Jay-esp/modular_tester/dmx_tester/modular_tester_dmx_v1_1.png

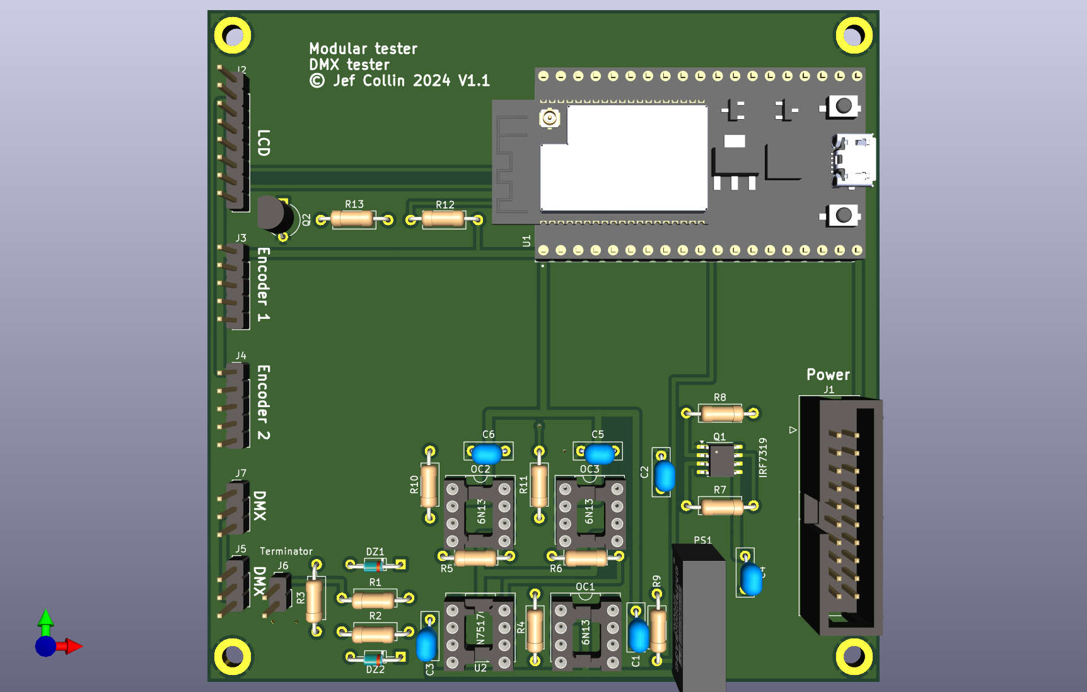
dmx_tester/modular_tester_dmx_v1_1.png
