Jay-esp/modular_tester/battery_tester/modular_tester_battery_tester_1_1.png

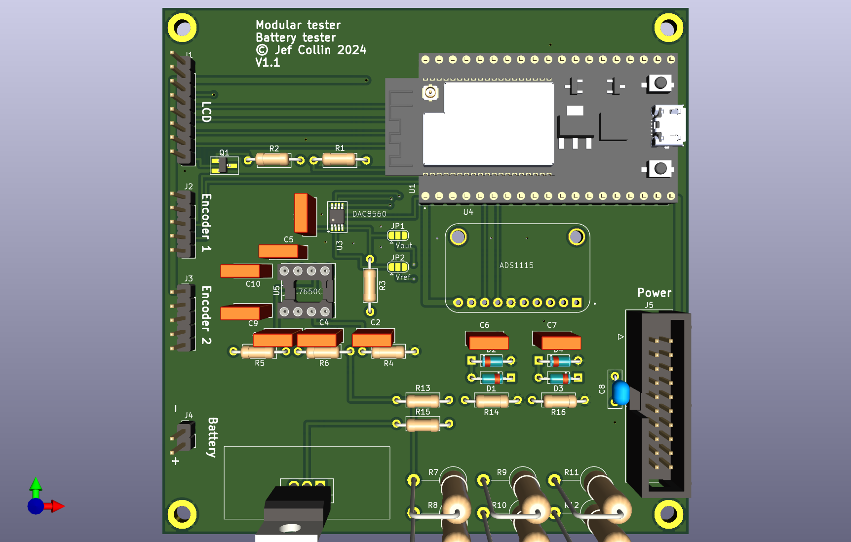
battery_tester/modular_tester_battery_tester_1_1.png
