Jay-esp/modular_tester/capacitor_foil_side_tester/modular_tester_capacitor_foil_side_1_2.png

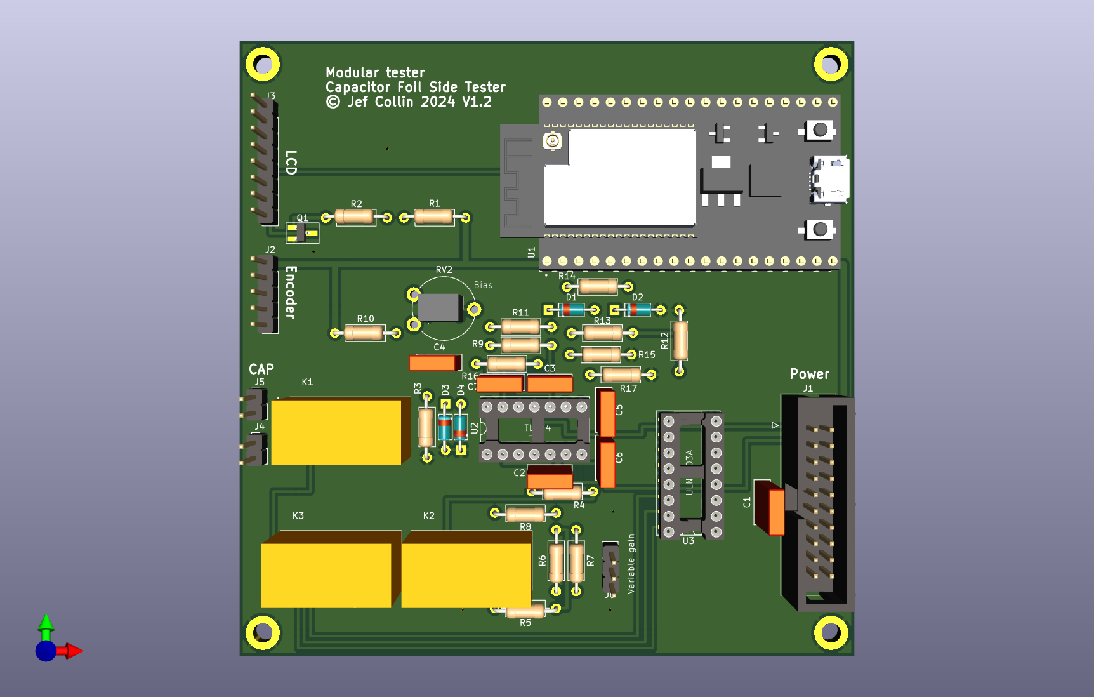
capacitor_foil_side_tester/modular_tester_capacitor_foil_side_1_2.png
