Jay-esp/modular_tester/esr_meter/modular_tester_esr_v2_1.png

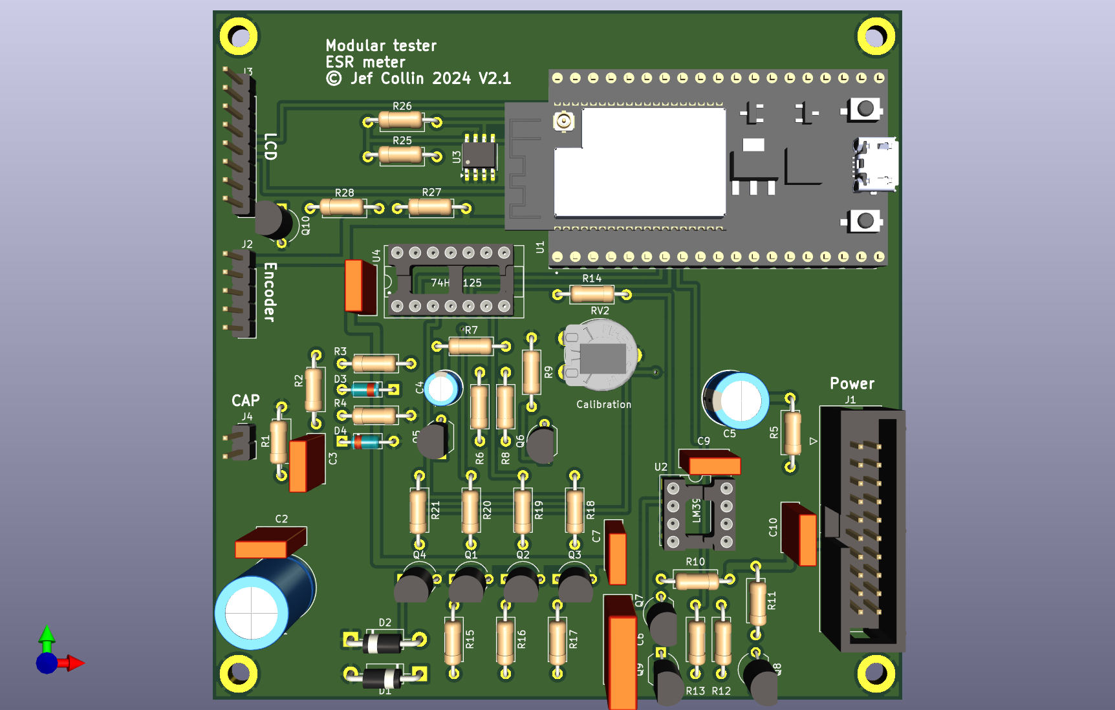
esr_meter/modular_tester_esr_v2_1.png
