Jay-esp/modular_tester/noise_generator/modular_tester_noise_1_1.png

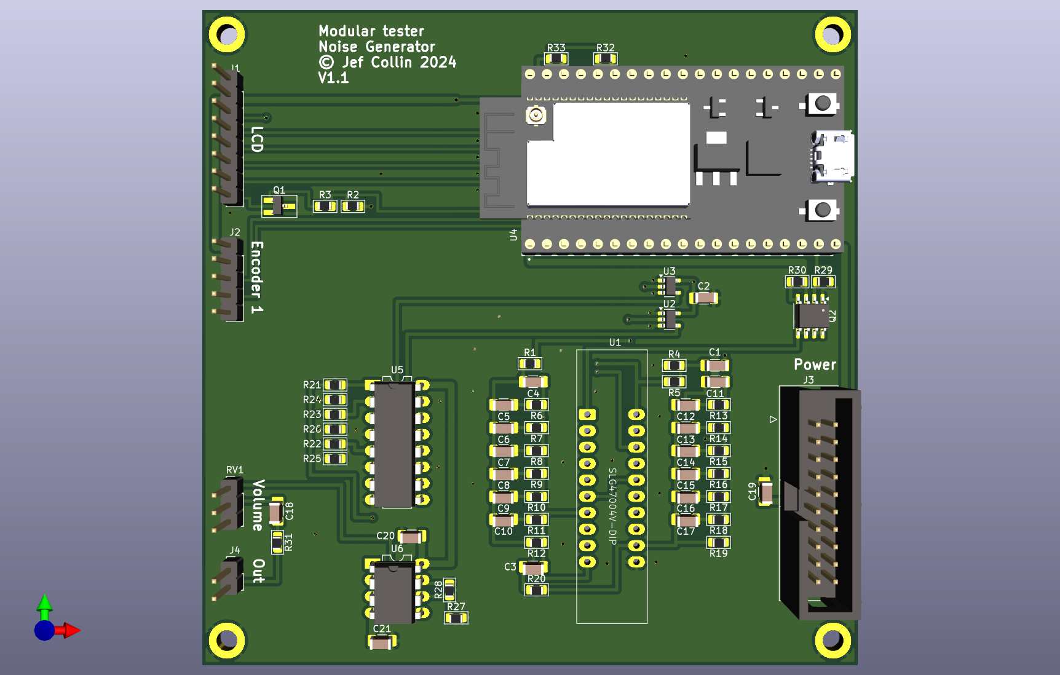
noise_generator/modular_tester_noise_1_1.png
