Jay-esp/modular_tester/rack_power_board/modular_tester_rack_power2.png

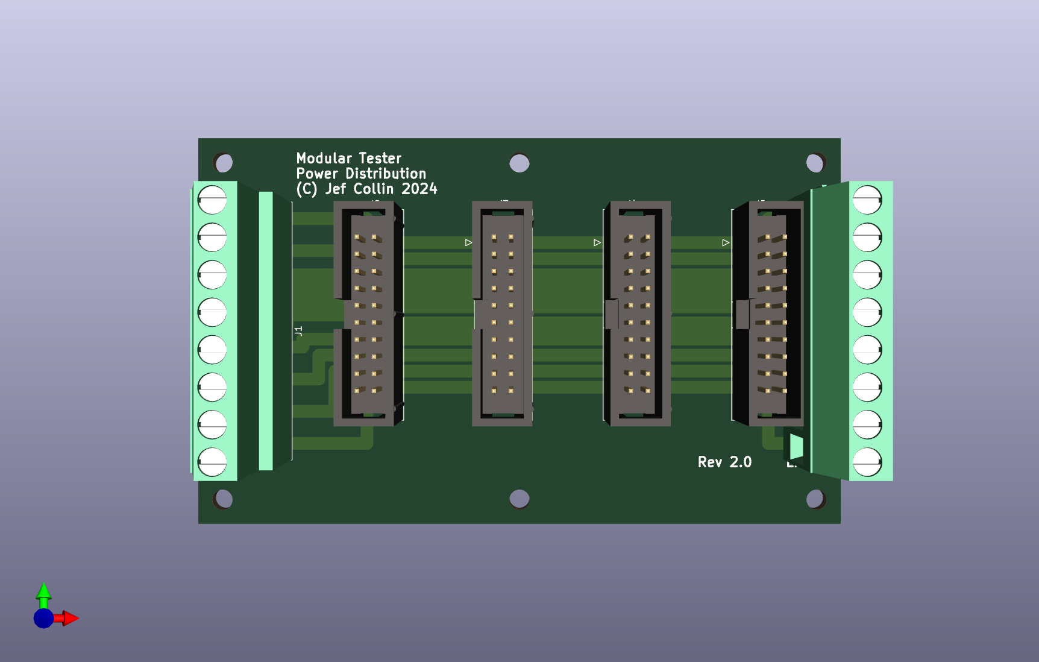
rack_power_board/modular_tester_rack_power2.png
