Jay-esp/modular_tester/rf_probe_up/modular_tester_rf_probe_mcl_1_0.png

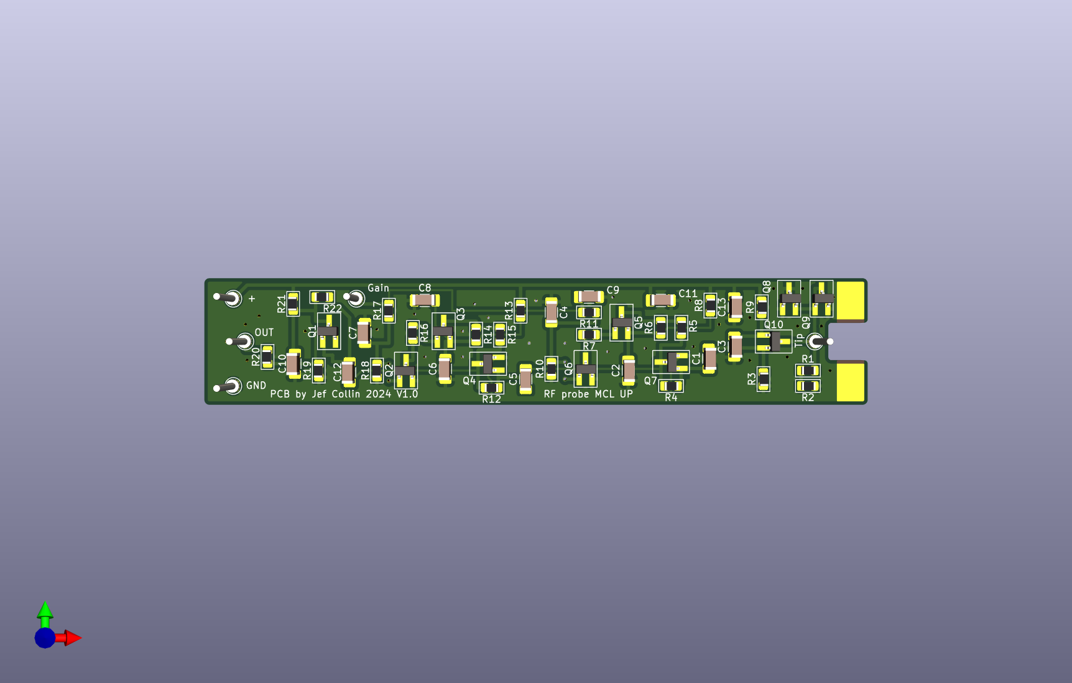
rf_probe_up/modular_tester_rf_probe_mcl_1_0.png
