Jay-esp/modular_tester/ring_tester/modular_tester_ring_tester_1_0.png

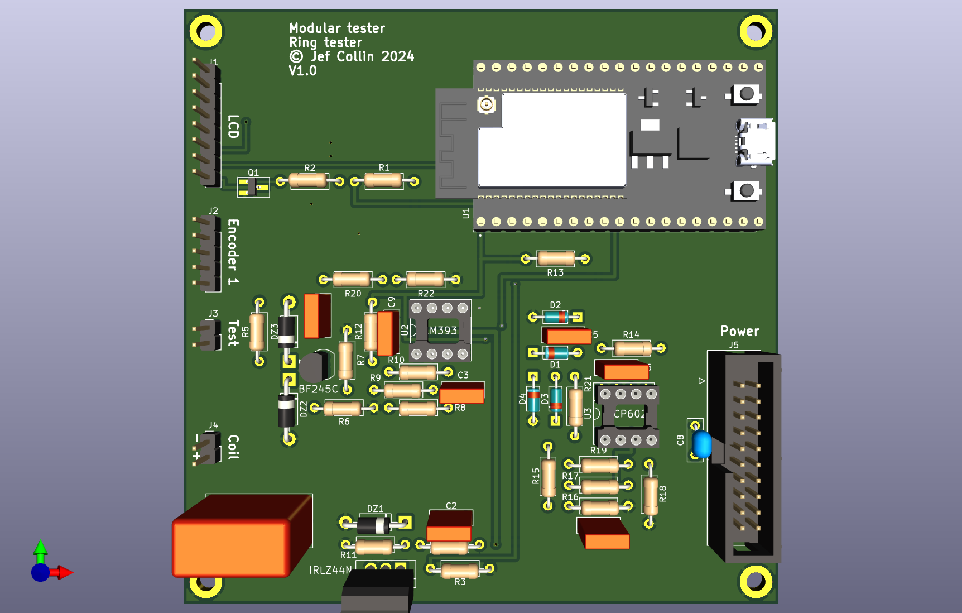
ring_tester/modular_tester_ring_tester_1_0.png
