Jay-esp/modular_tester/short_seeker/modular_tester_short_seeker_1_1.png

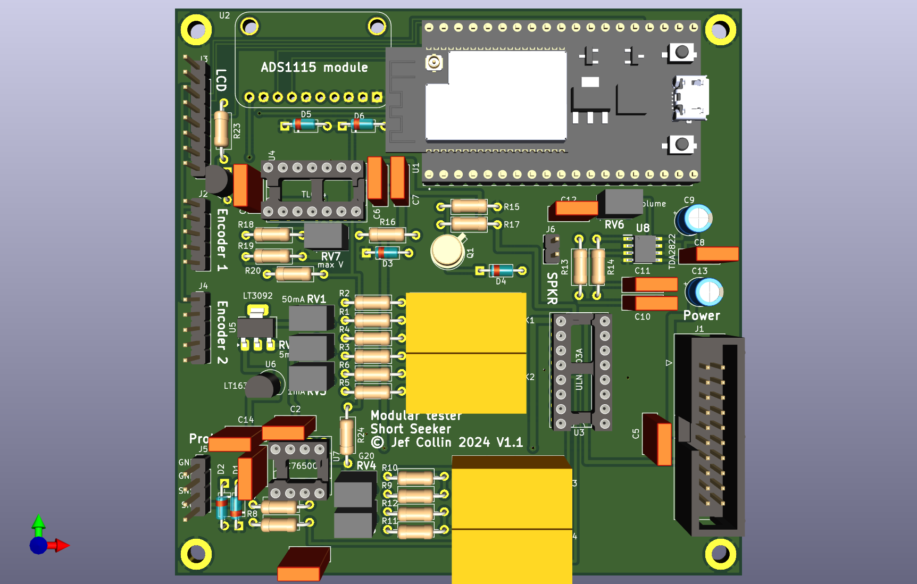
short_seeker/modular_tester_short_seeker_1_1.png
