Jay-esp/modular_tester/signal_tracer/modular_tester_signal_tracer_1_1.png

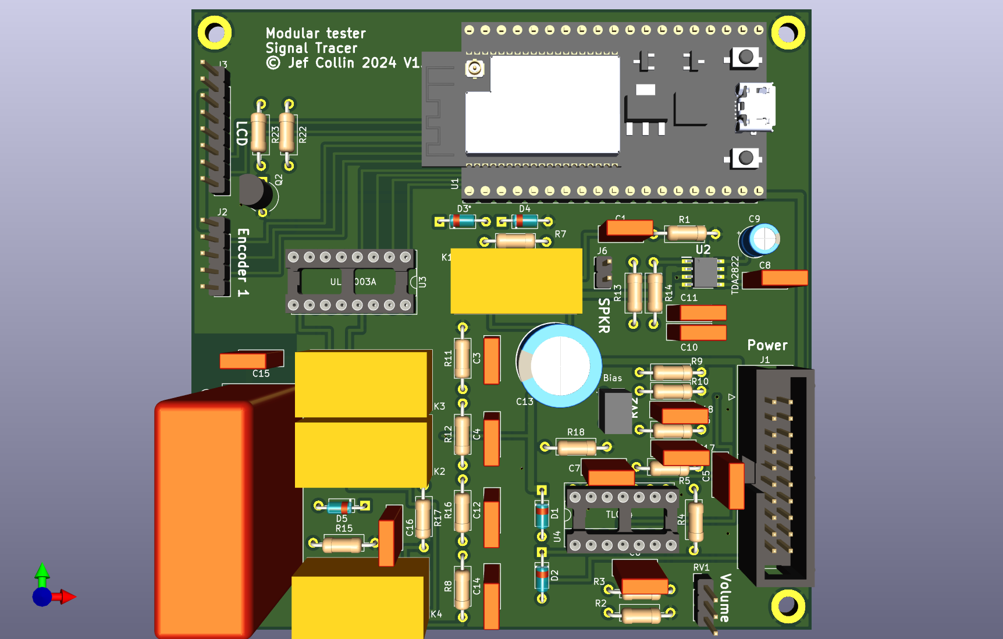
signal_tracer/modular_tester_signal_tracer_1_1.png
