Jay-esp/modular_tester/vi_tracker/modular_tester_vi_tracker_input_1_1.png

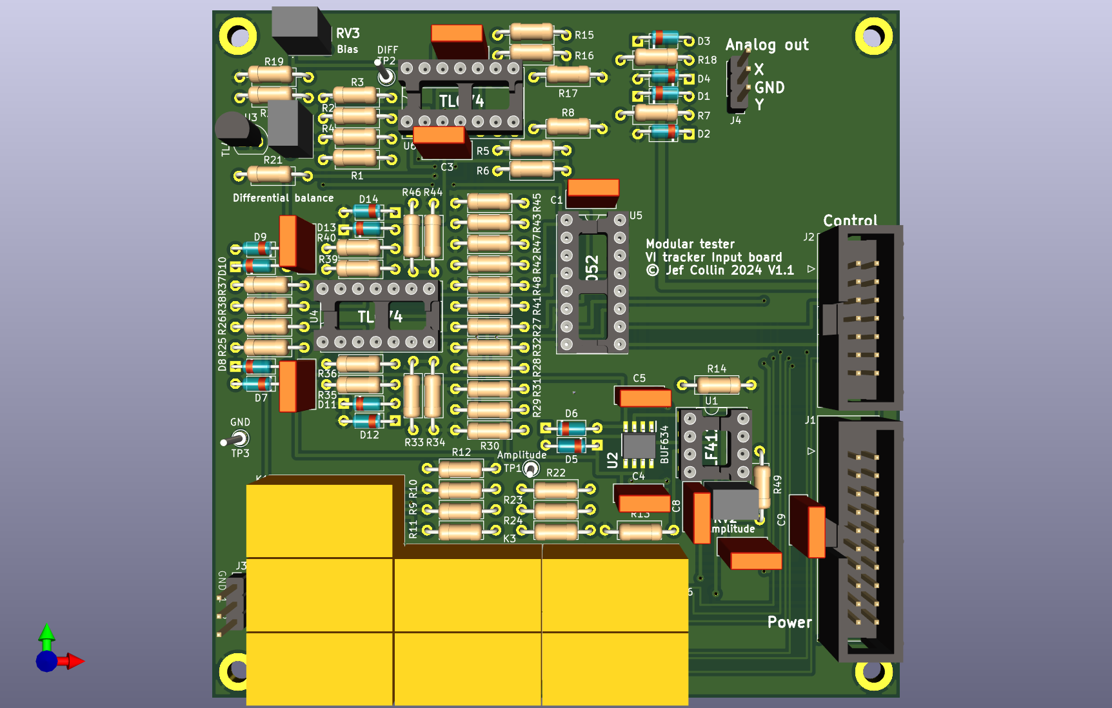
vi_tracker/modular_tester_vi_tracker_input_1_1.png
