Jay-esp/modular_tester/noise_generator/modular_tester_noise_1_1.pdf

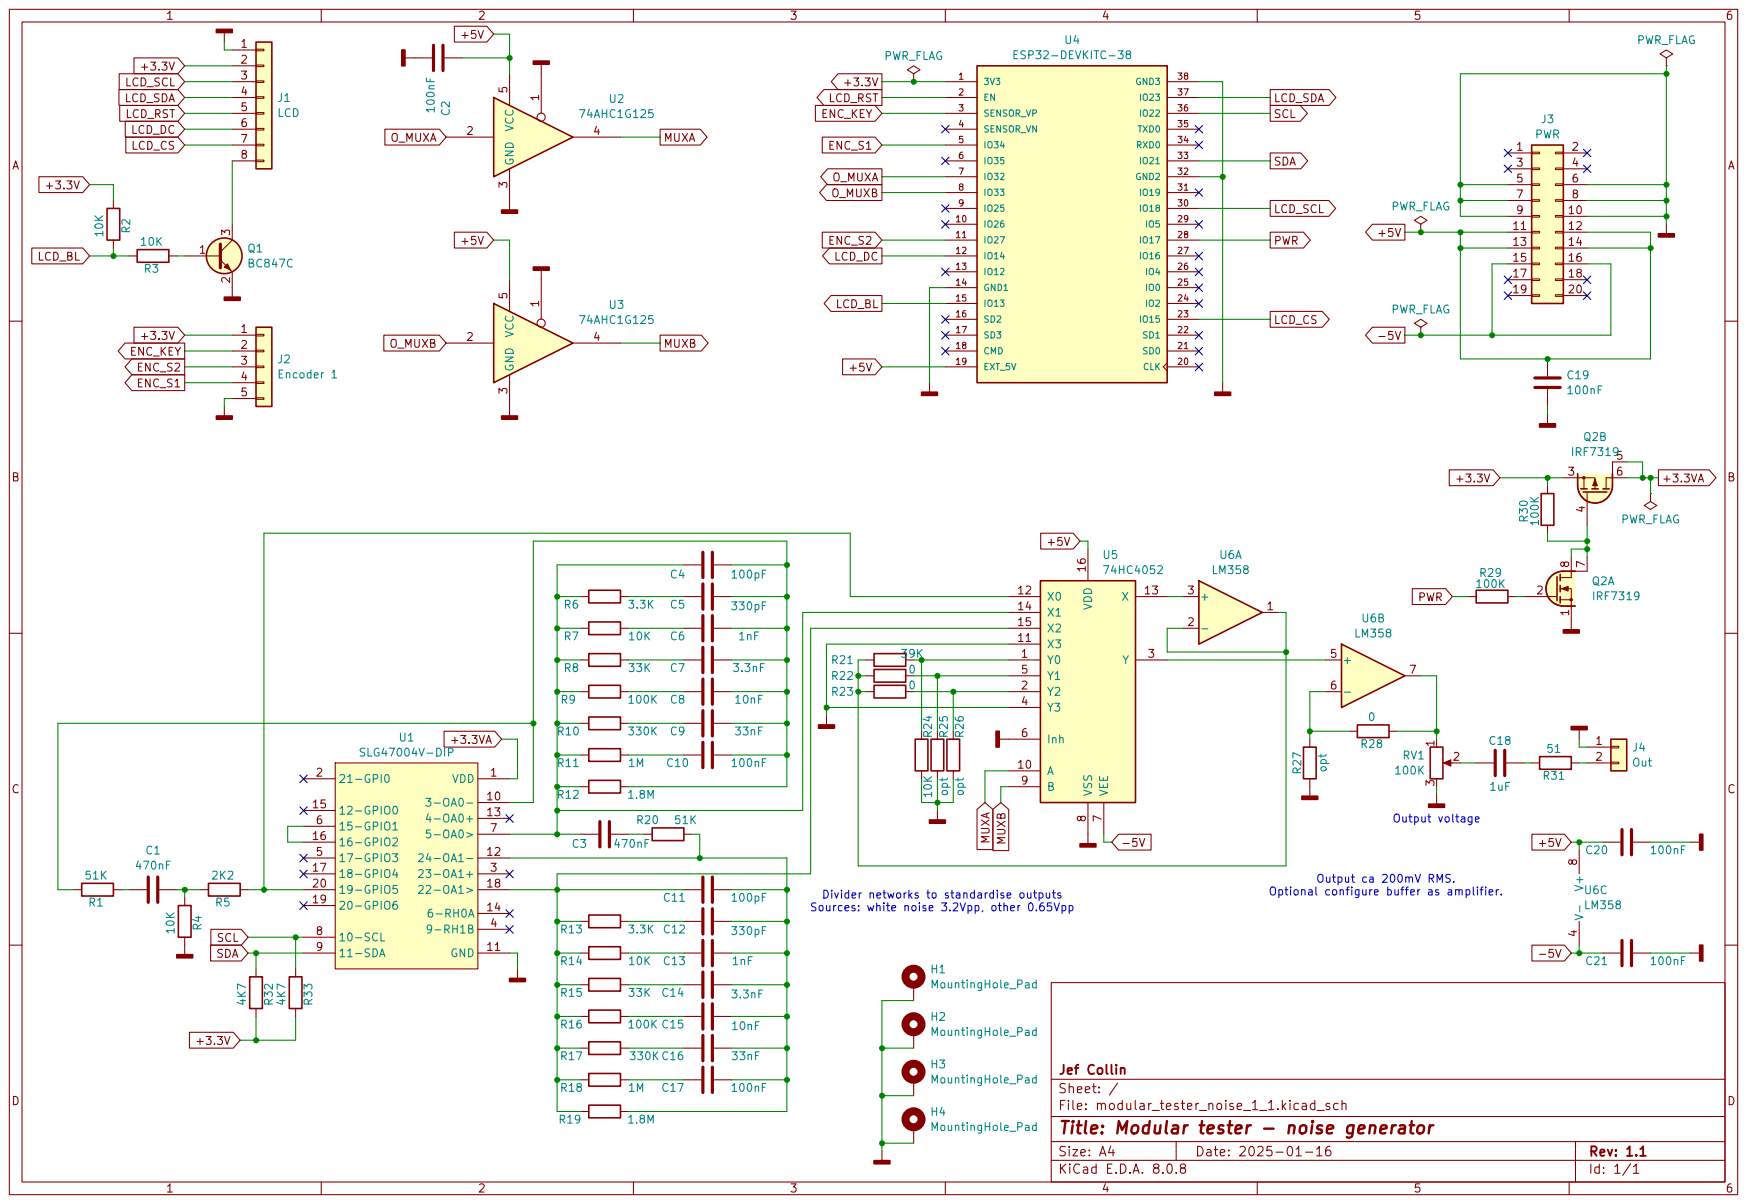
[picture p84: page 1]
