Jay-esp/modular_tester/fm_transmitter/modular_tester_fm_tx_1_1.pdf

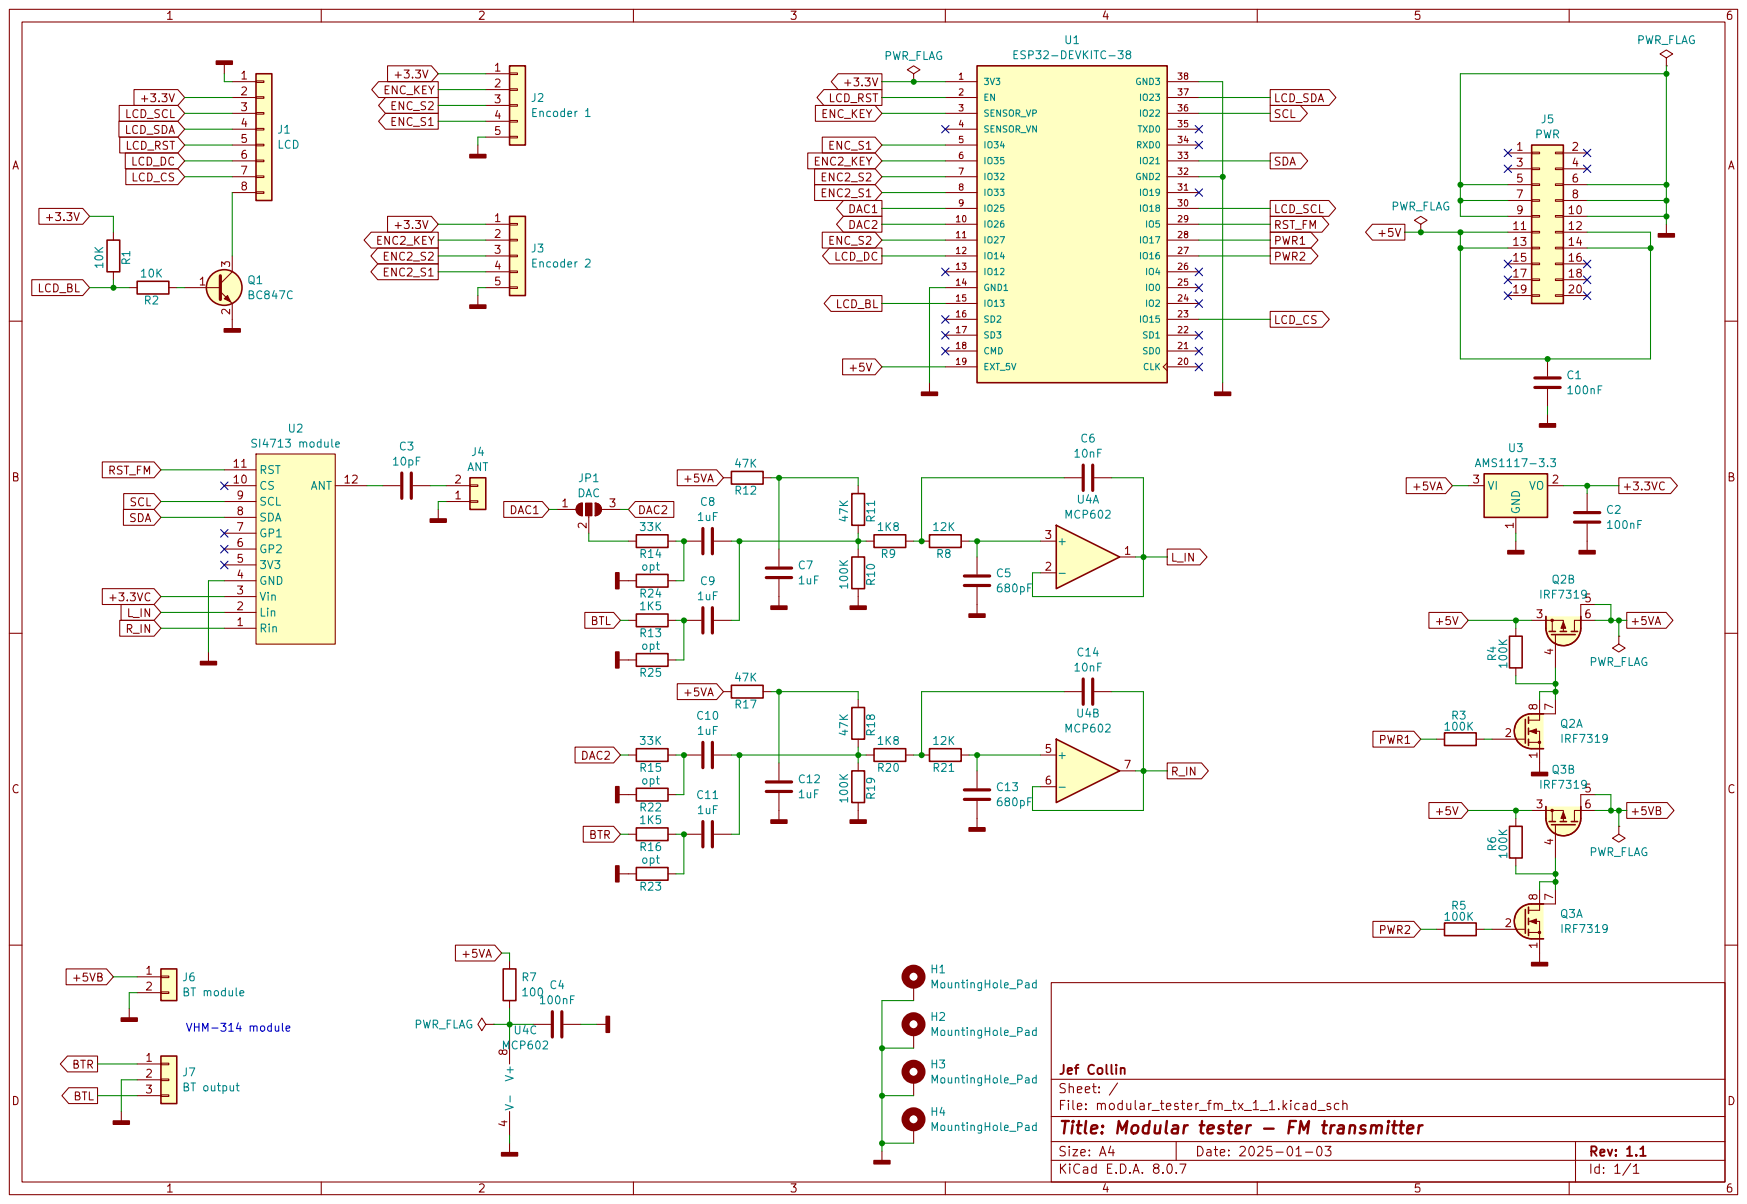
[picture p85: page 1]
