Jay-esp/modular_tester/battery_tester/modular_tester_battery_tester_1_1.pdf

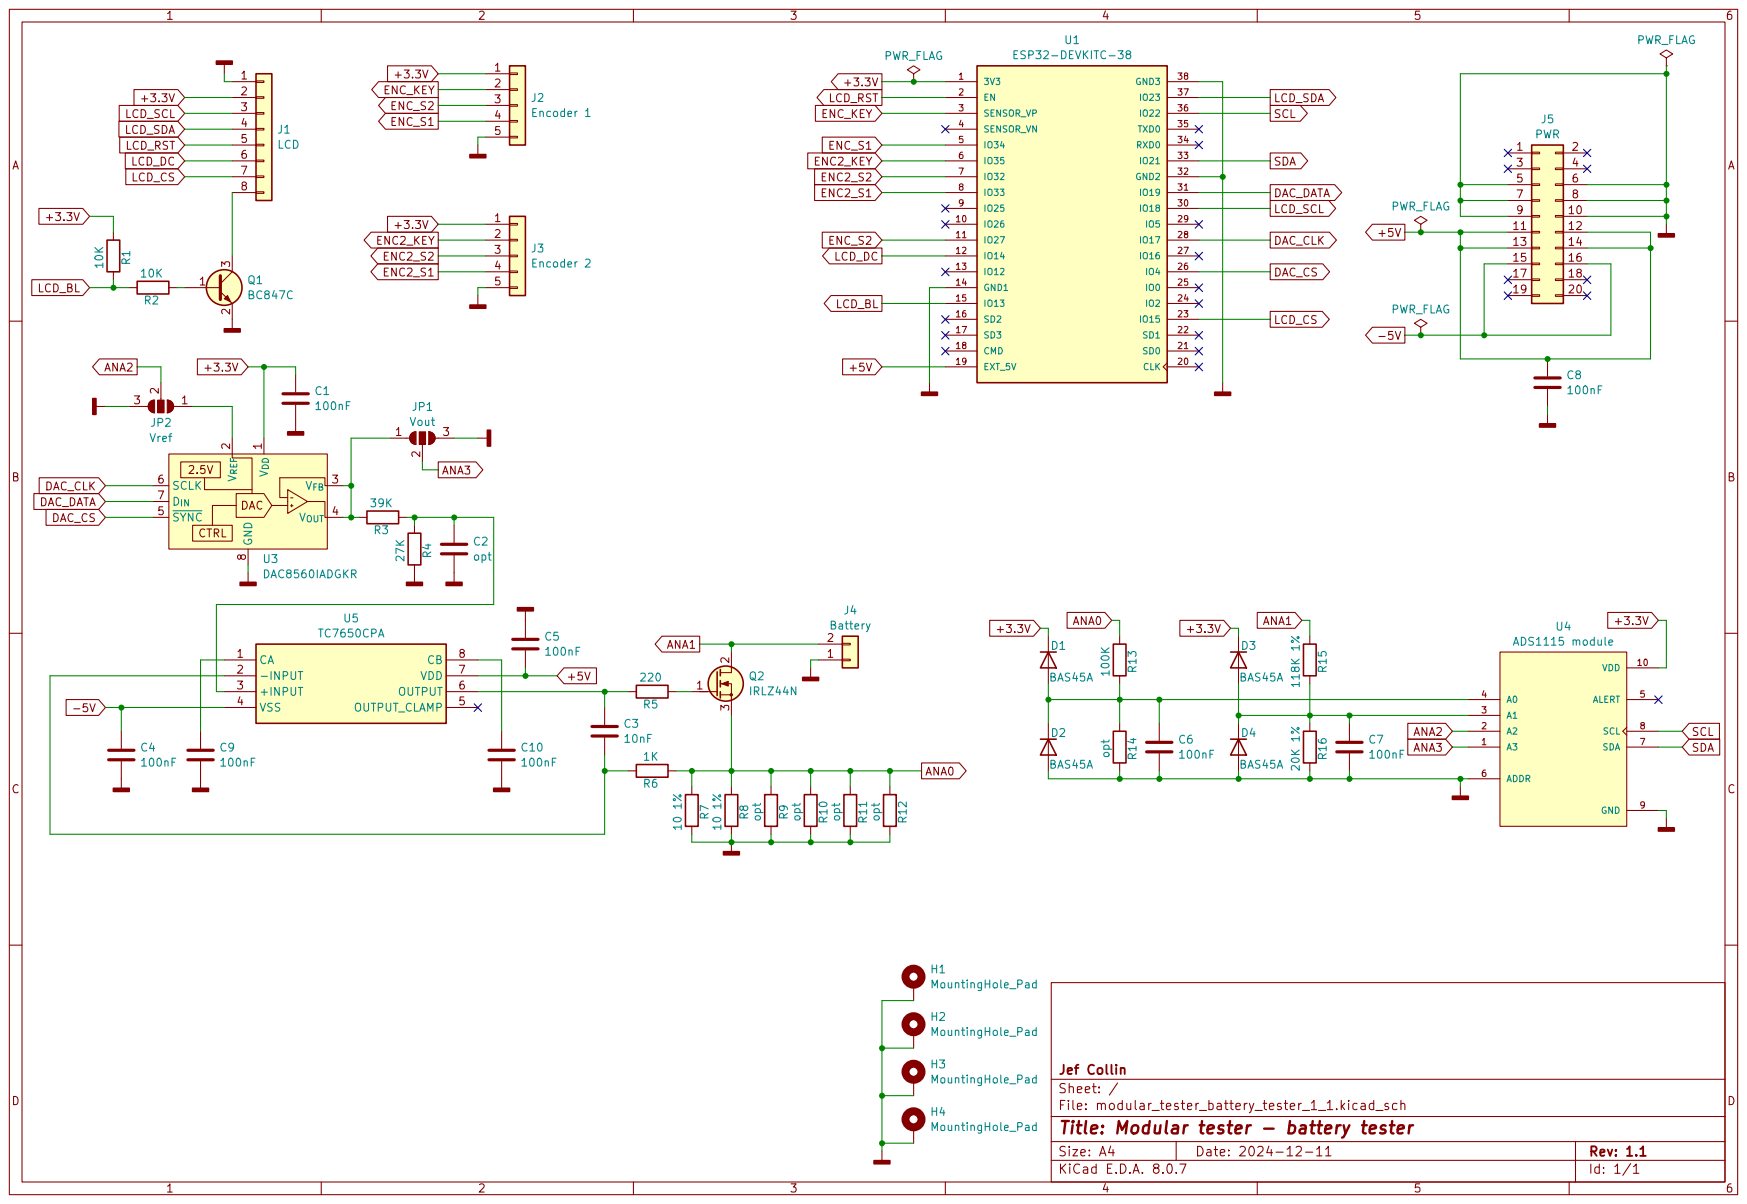
[picture p86: page 1]
