Jay-esp/modular_tester/LED_tester/modular_tester_led_tester_1_1.pdf

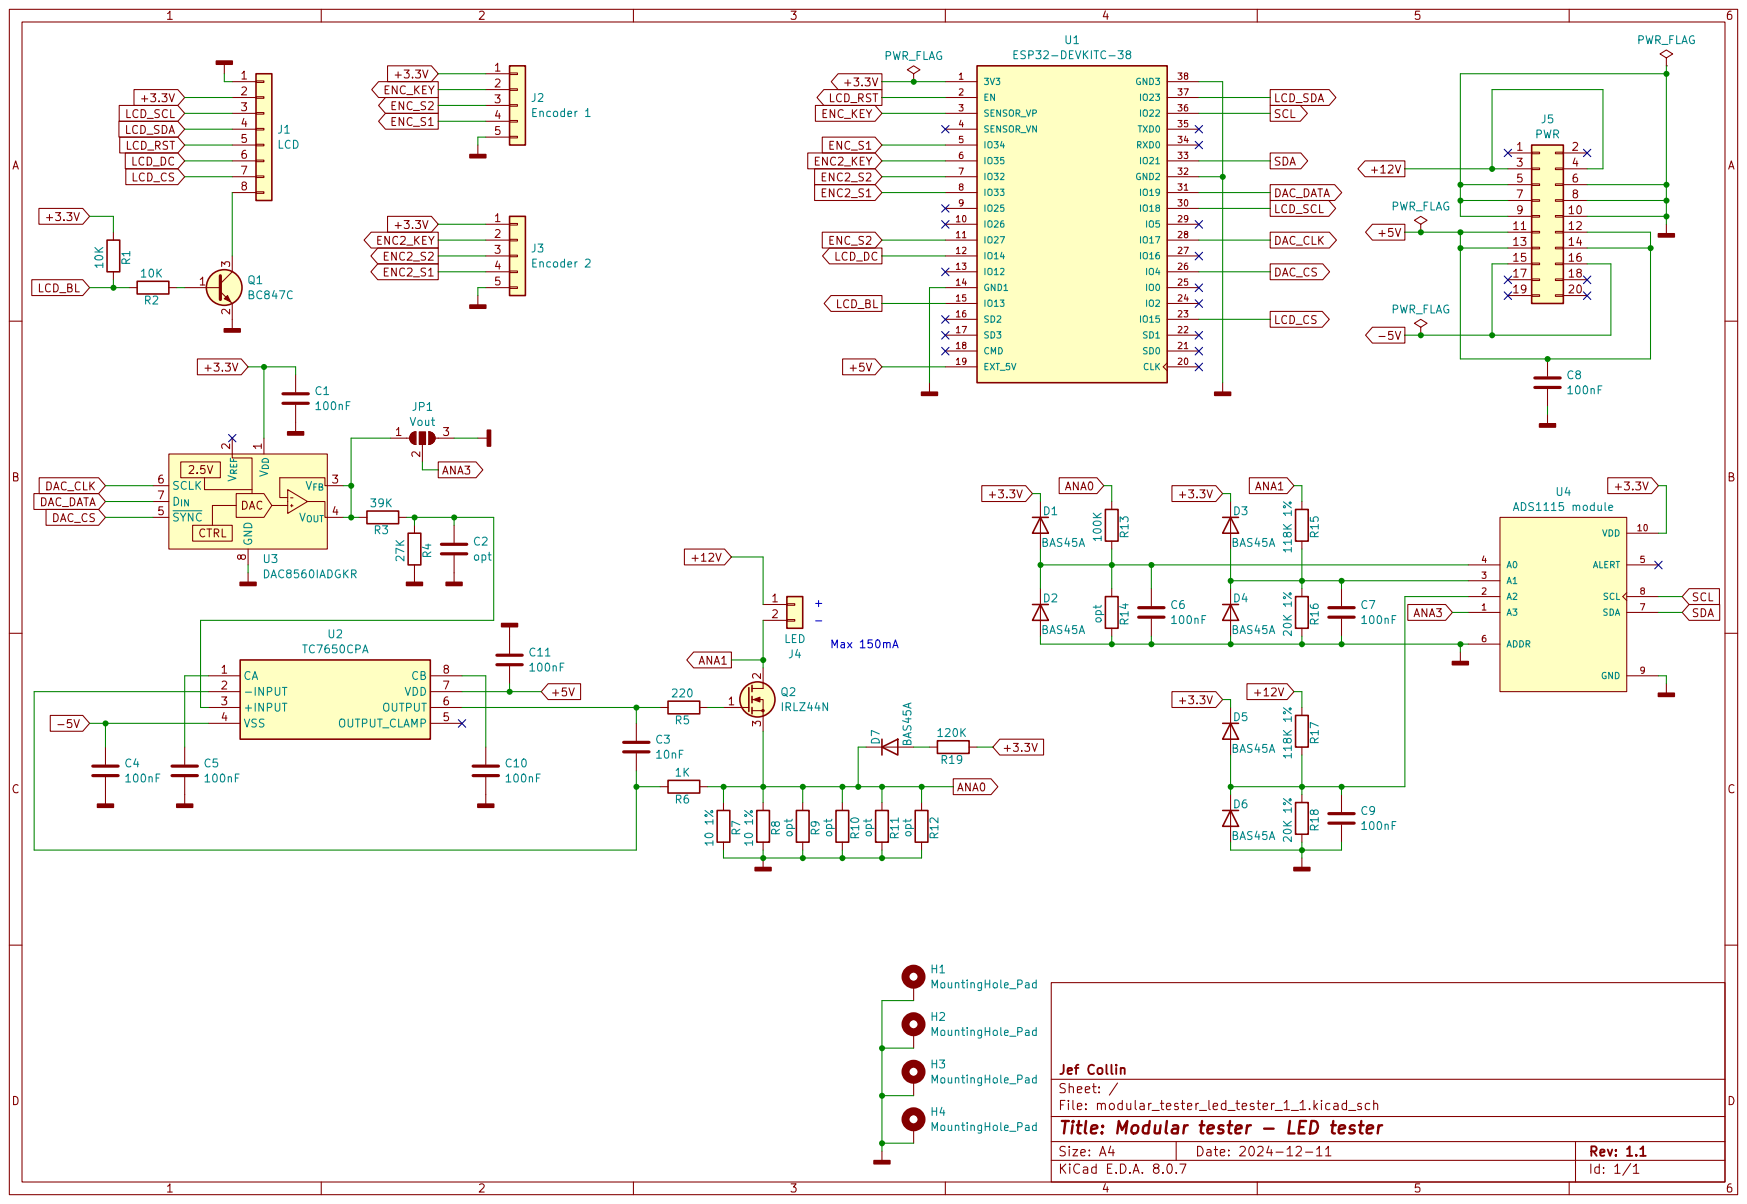
[picture p87: page 1]
