Jay-esp/modular_tester/ring_tester/modular_tester_ring_tester_1_0.pdf

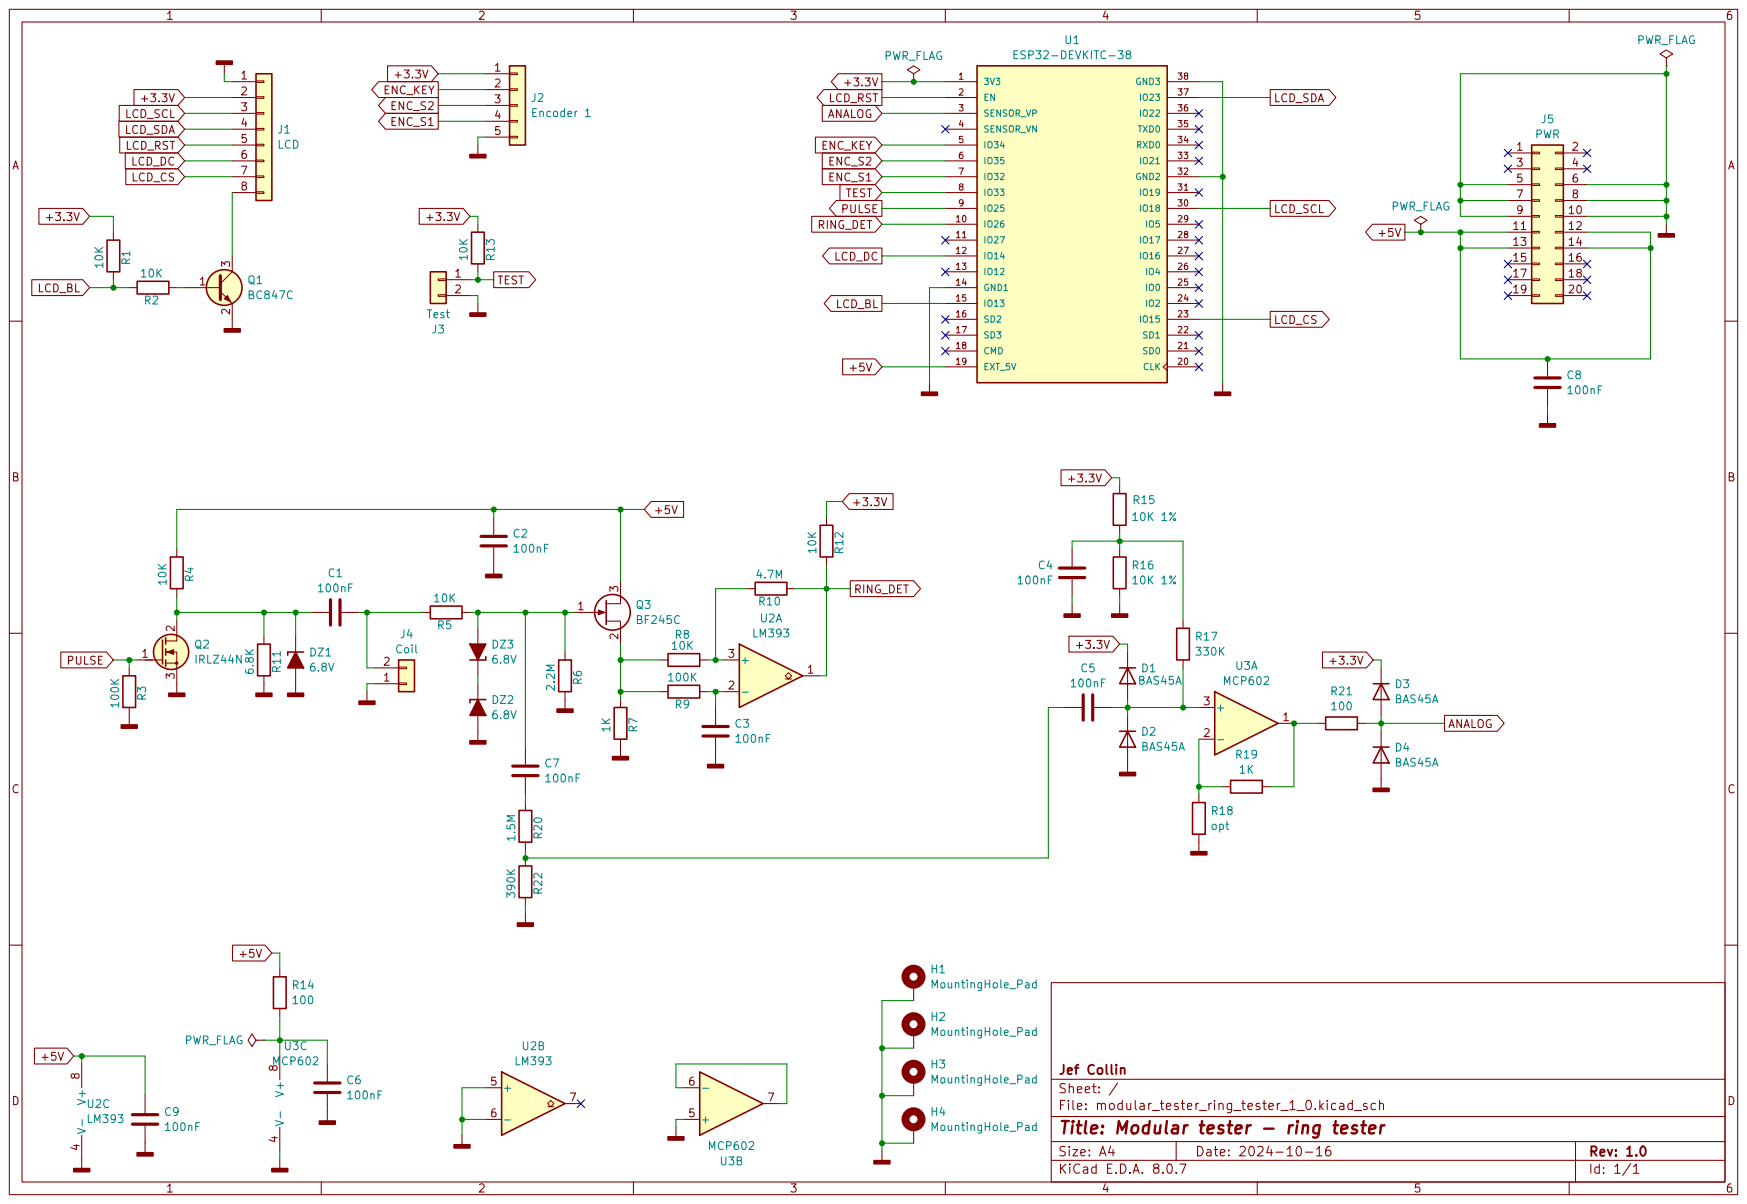
[picture p88: page 1]
