Jay-esp/modular_tester/clock_timer/modular_tester_clock_1_0.pdf

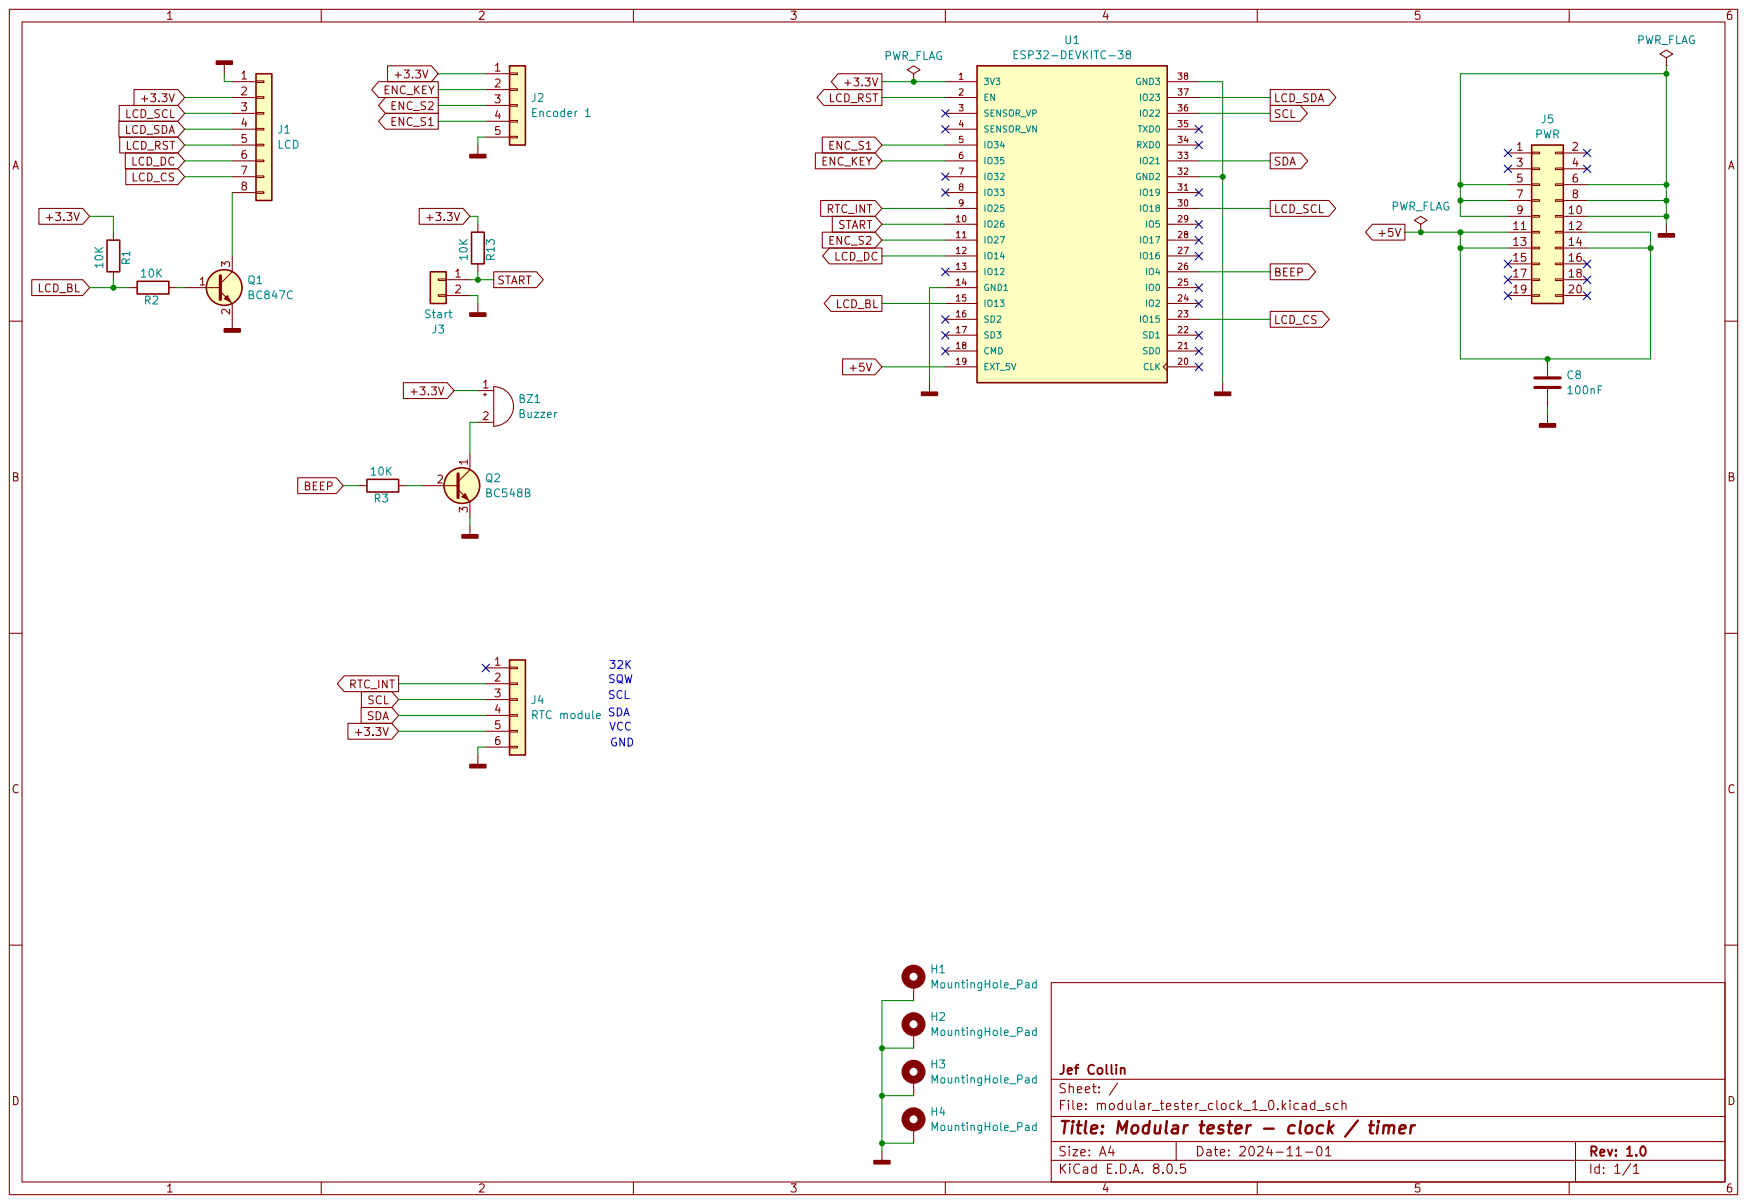
[picture p89: page 1]
