Jay-esp/modular_tester/vi_tracker/modular_tester_vi_tracker_1_1.pdf

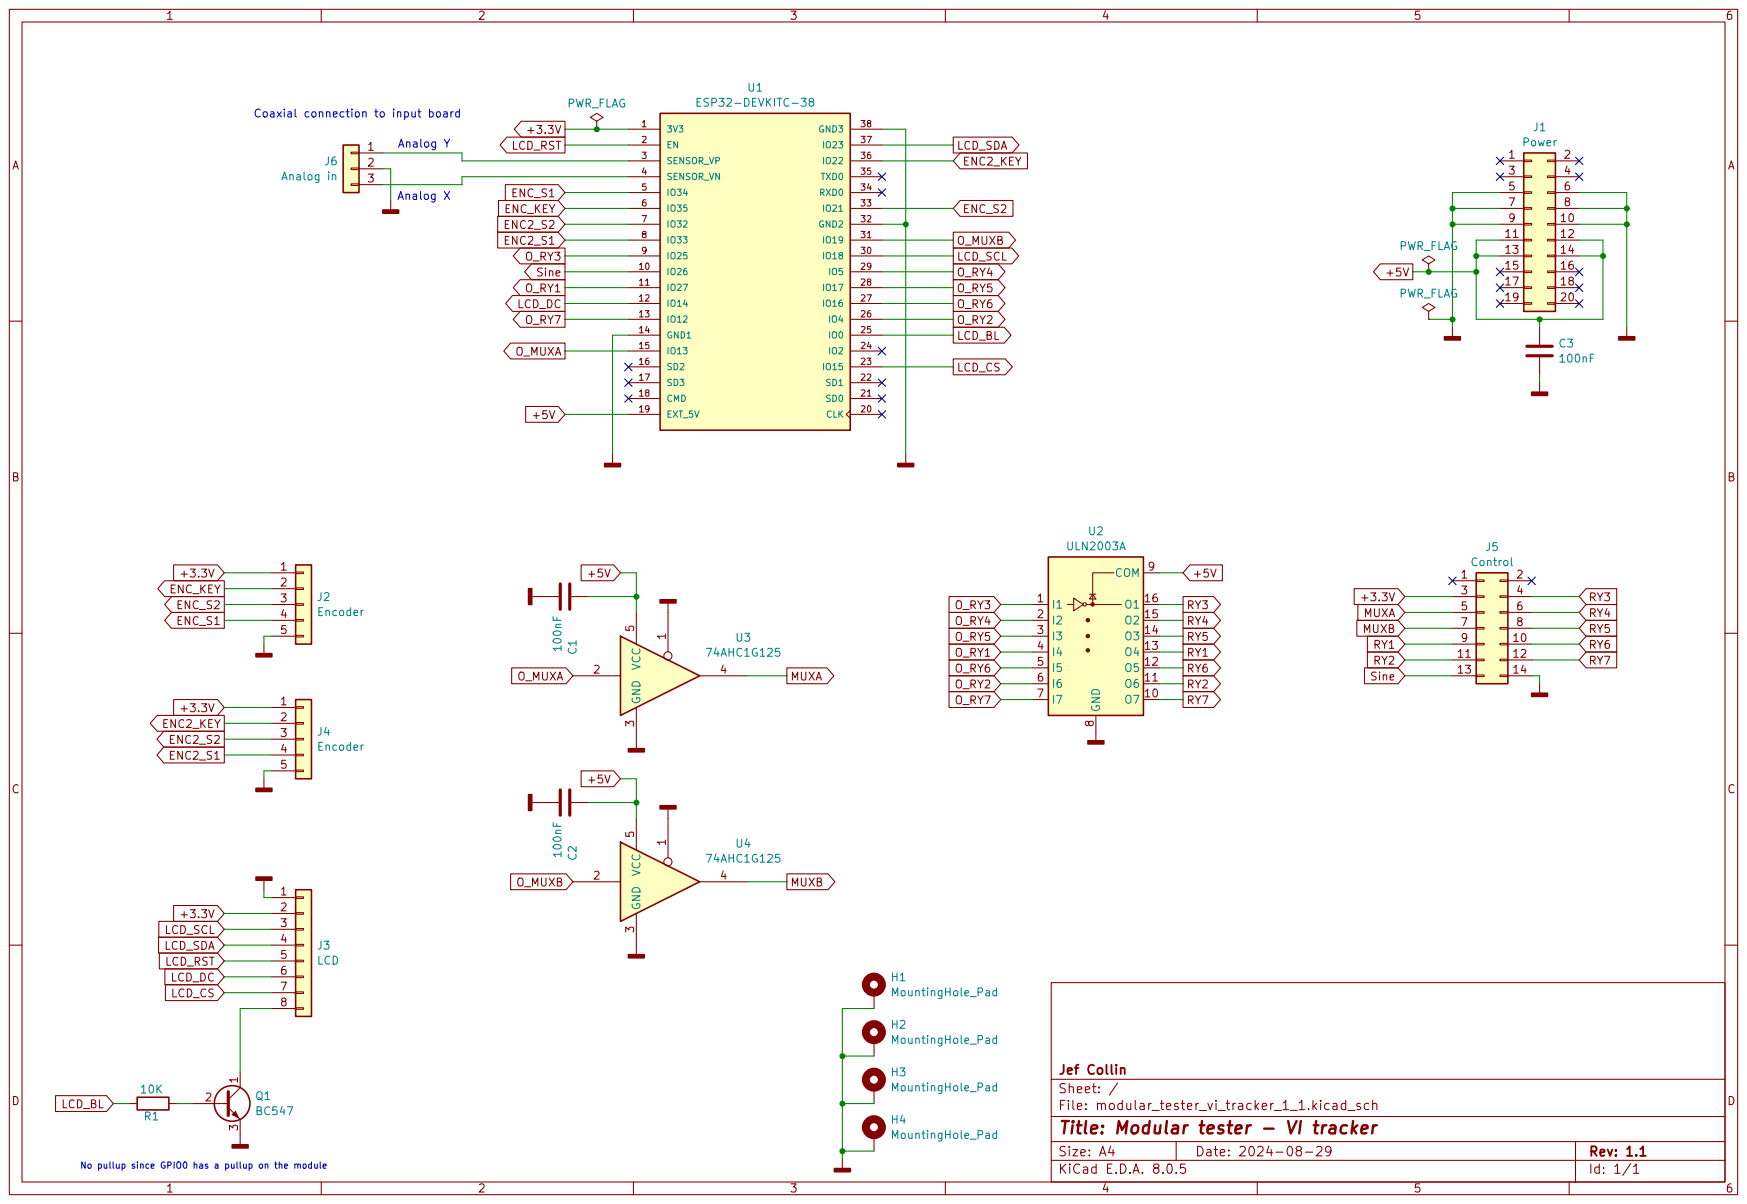
[picture p90: page 1]
