Jay-esp/modular_tester/short_seeker/modular_tester_short_seeker_1_1.pdf

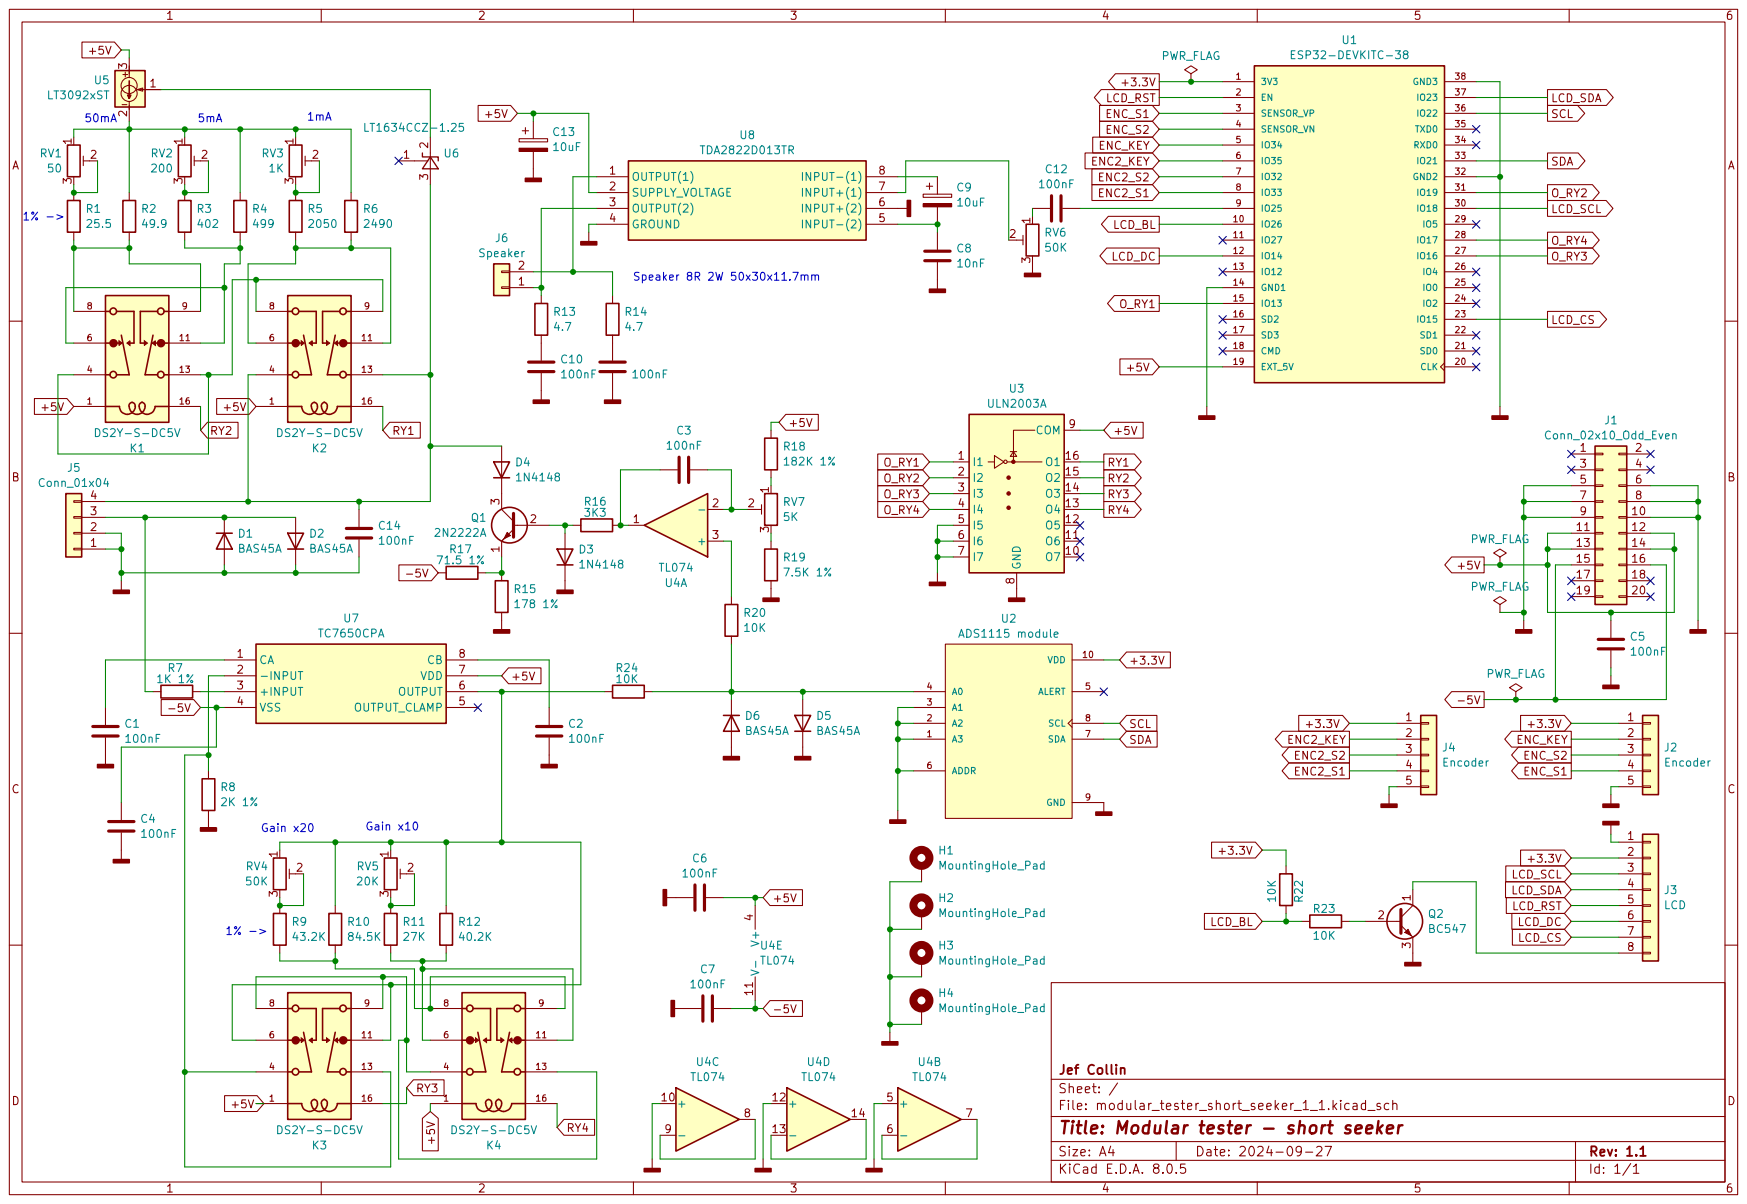
[picture p92: page 1]
