Jay-esp/modular_tester/esr_meter/modular_tester_esr_v2_1.pdf

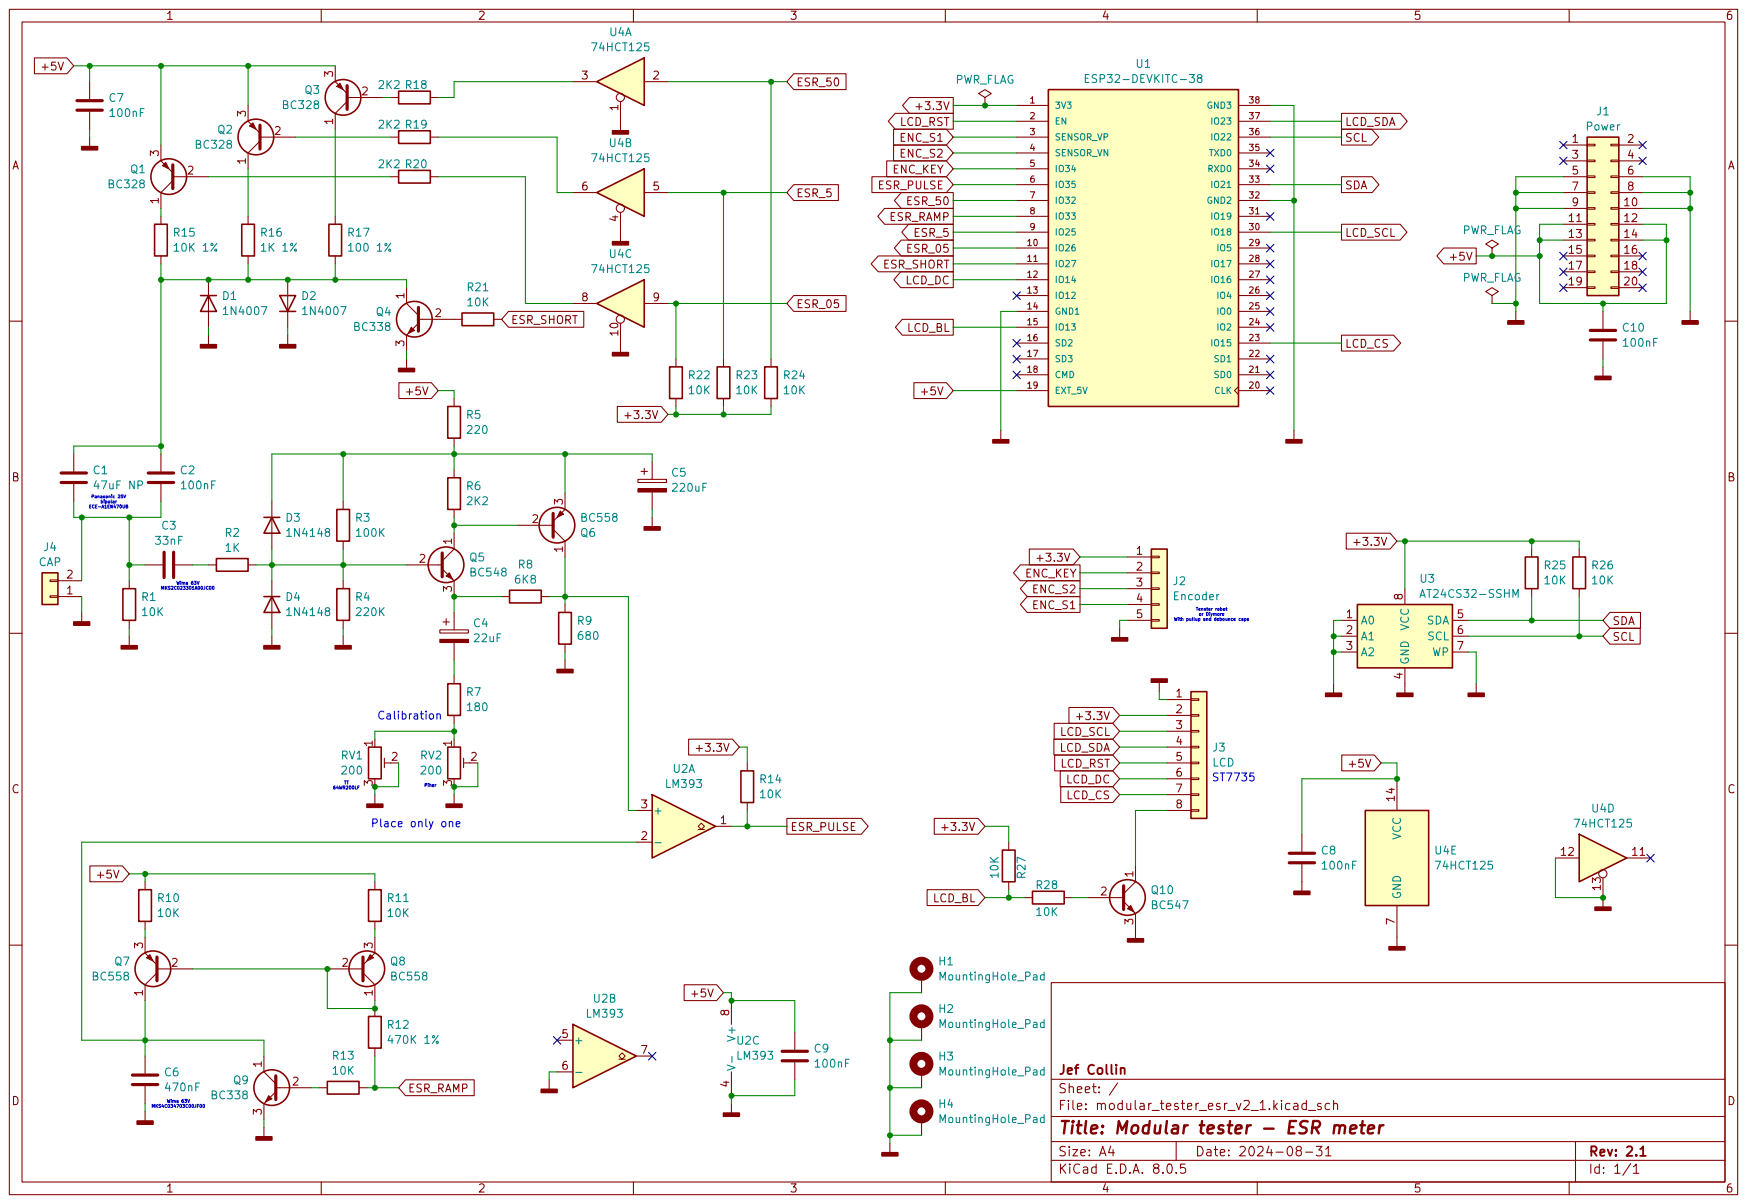
[picture p93: page 1]
