Jay-esp/modular_tester/capacitor_foil_side_tester/modular_tester_capacitor_foil_side_1_2.pdf

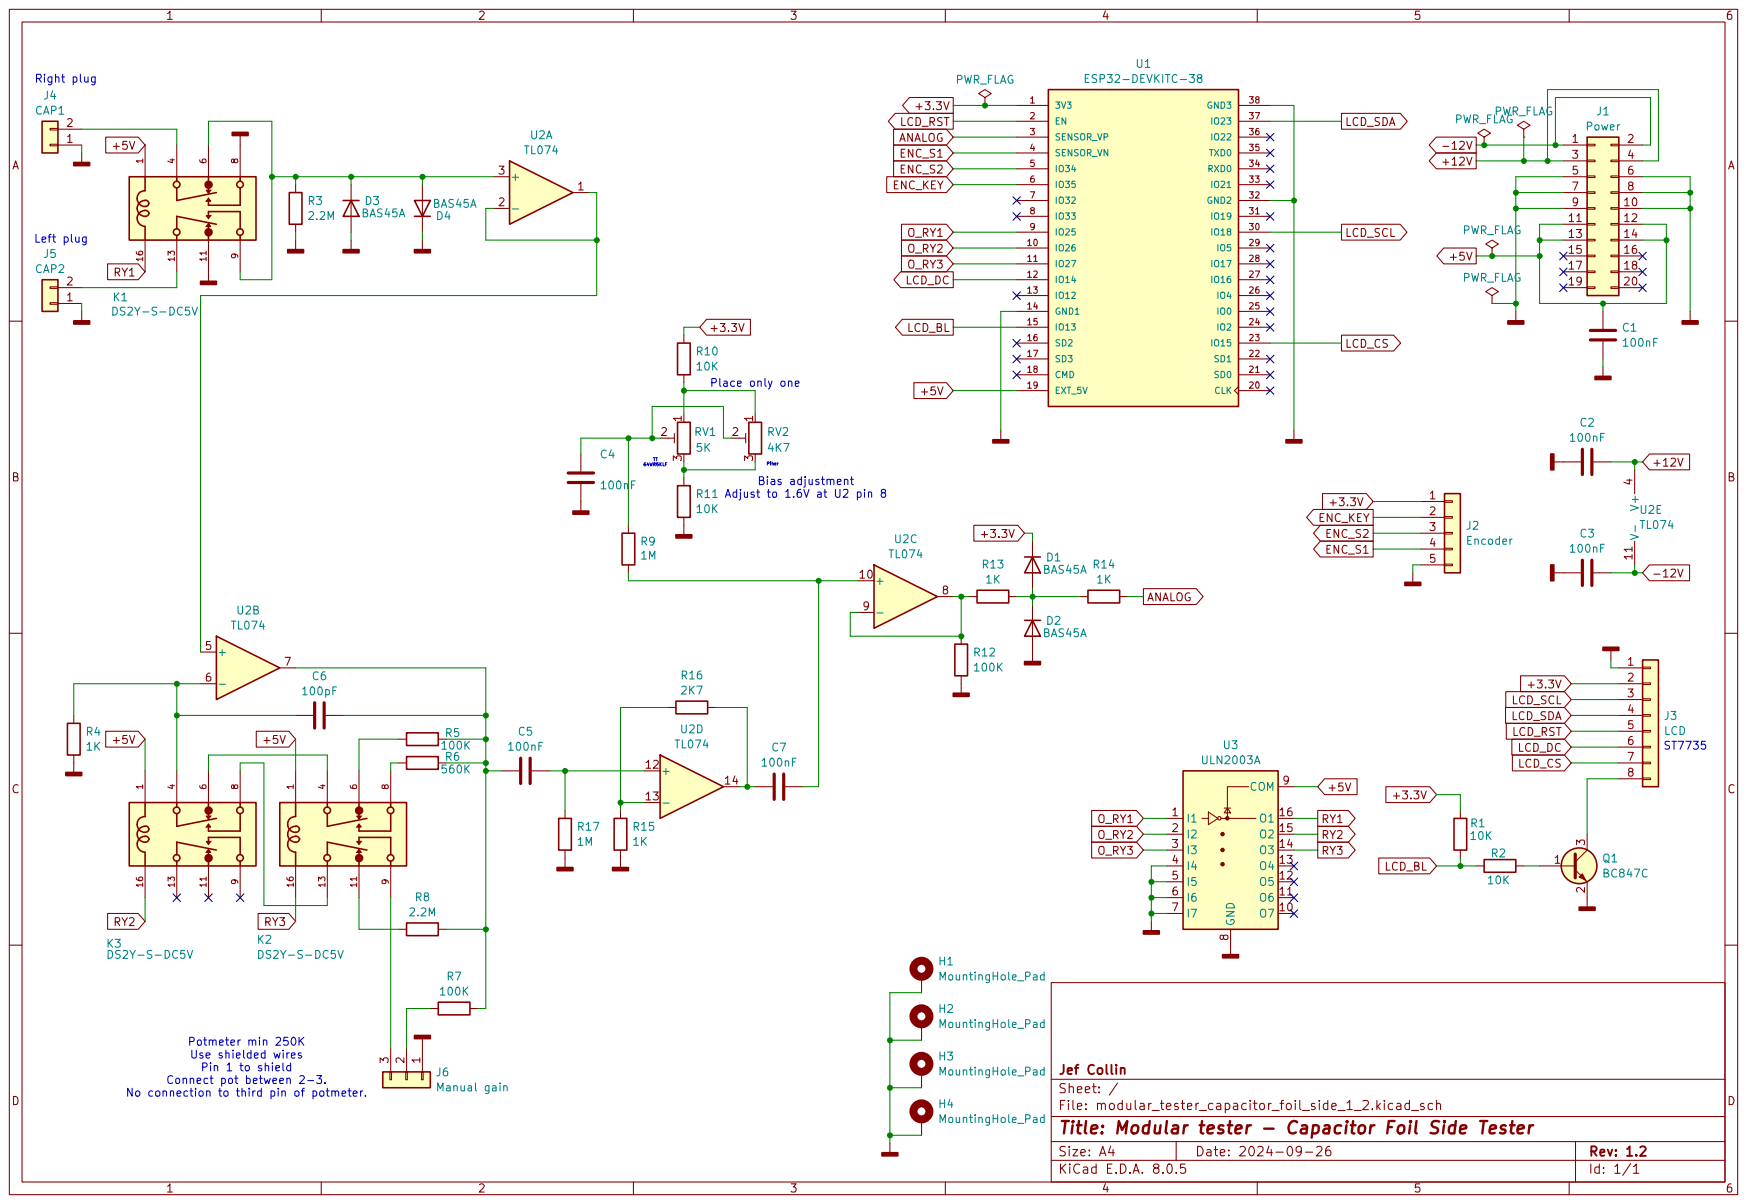
[picture p94: page 1]
