Jay-esp/modular_tester/dmx_tester/modular_tester_dmx_v1_1.pdf

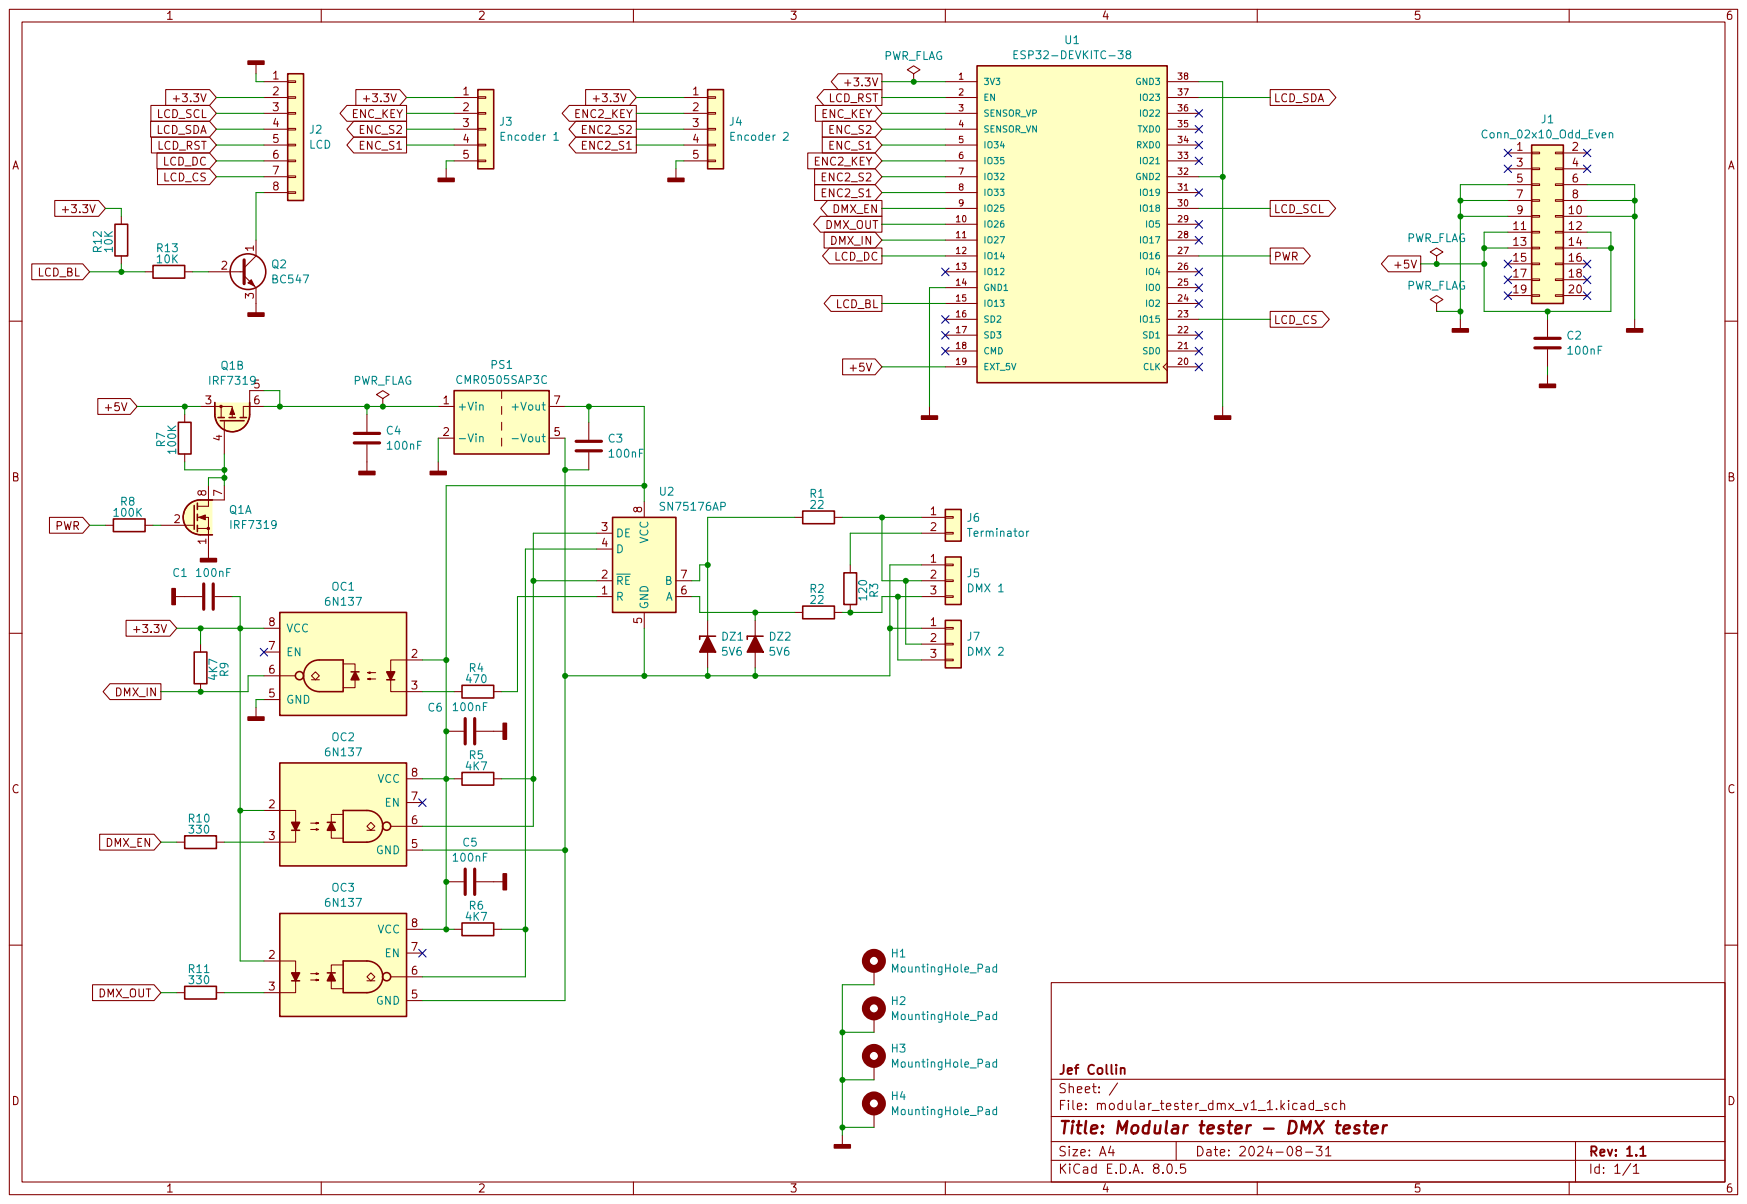
[picture p96: page 1]
