Jay-esp/modular_tester/cb_microphone_tester/modular_tester_cb_1_2.pdf

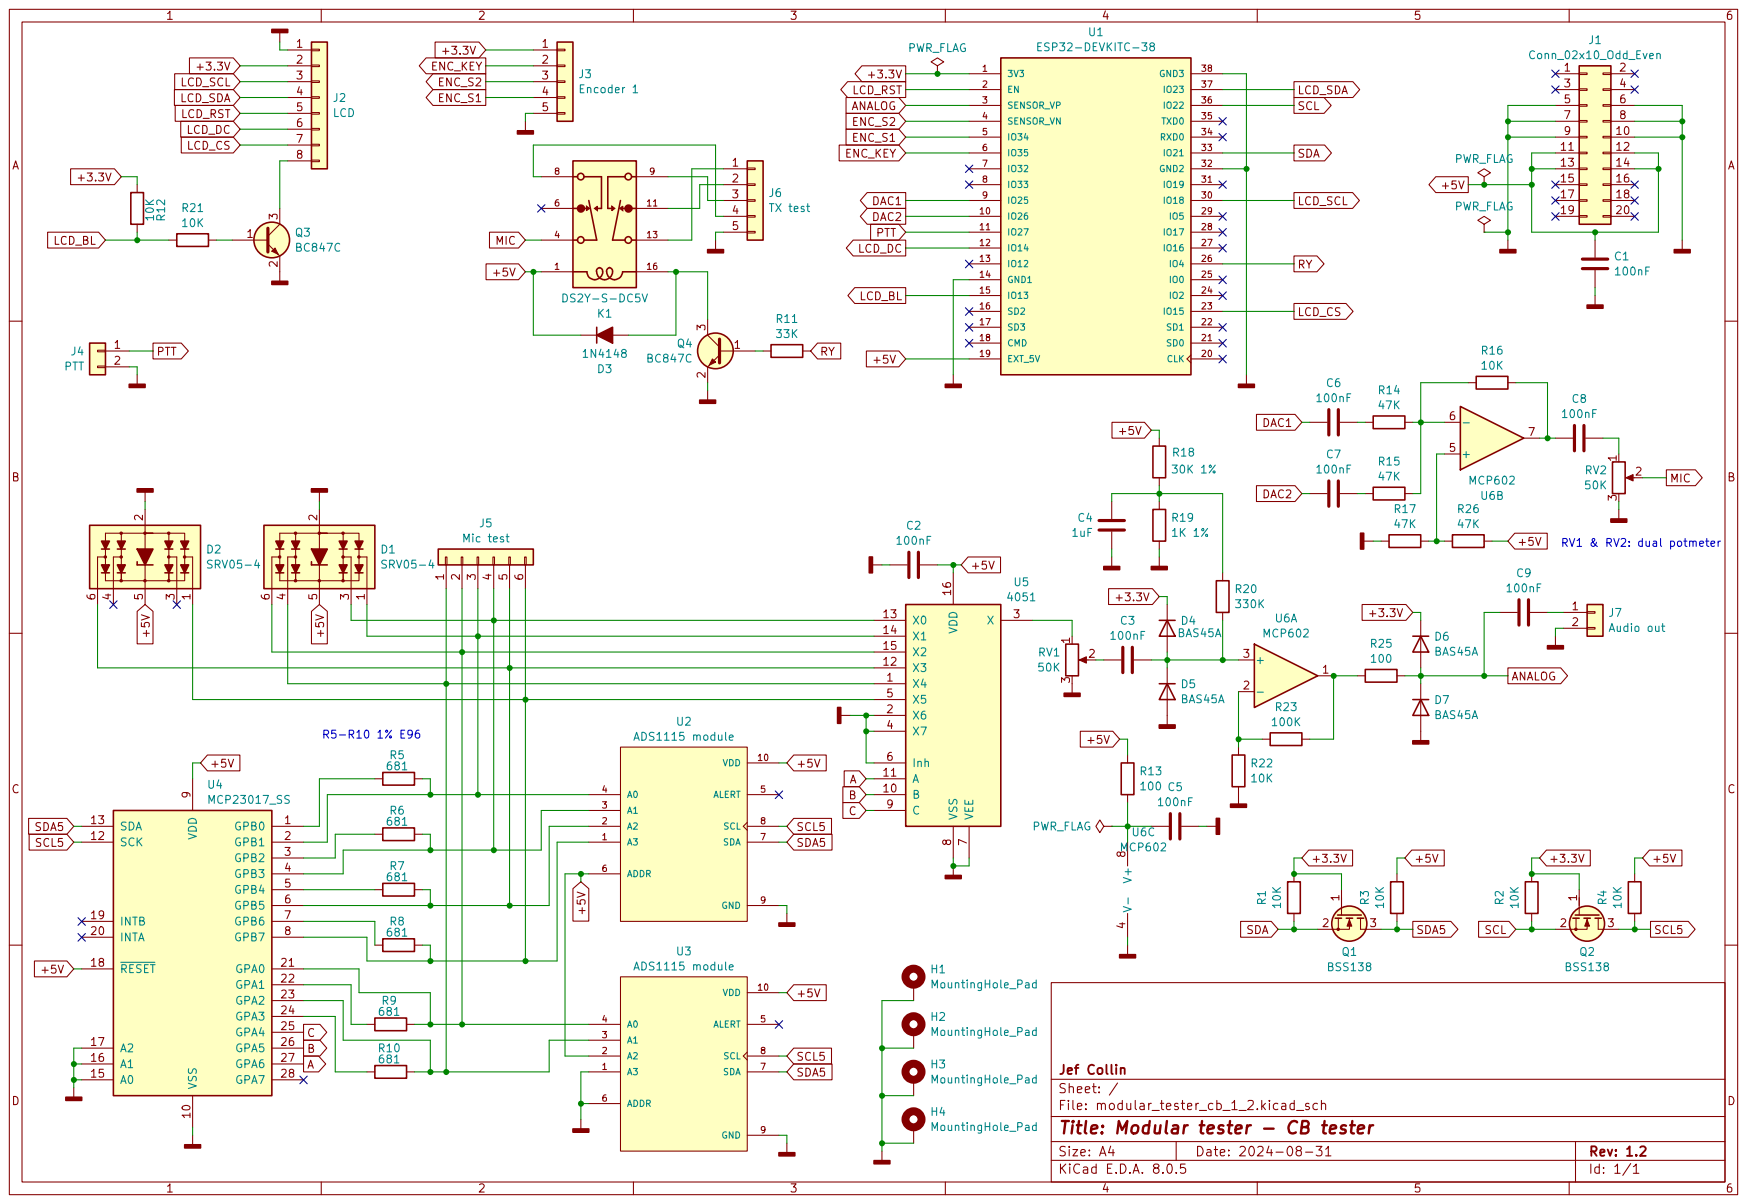
[picture p97: page 1]
