Jay-esp/modular_tester/prototype_board/modular_tester_prototype_1_1.pdf

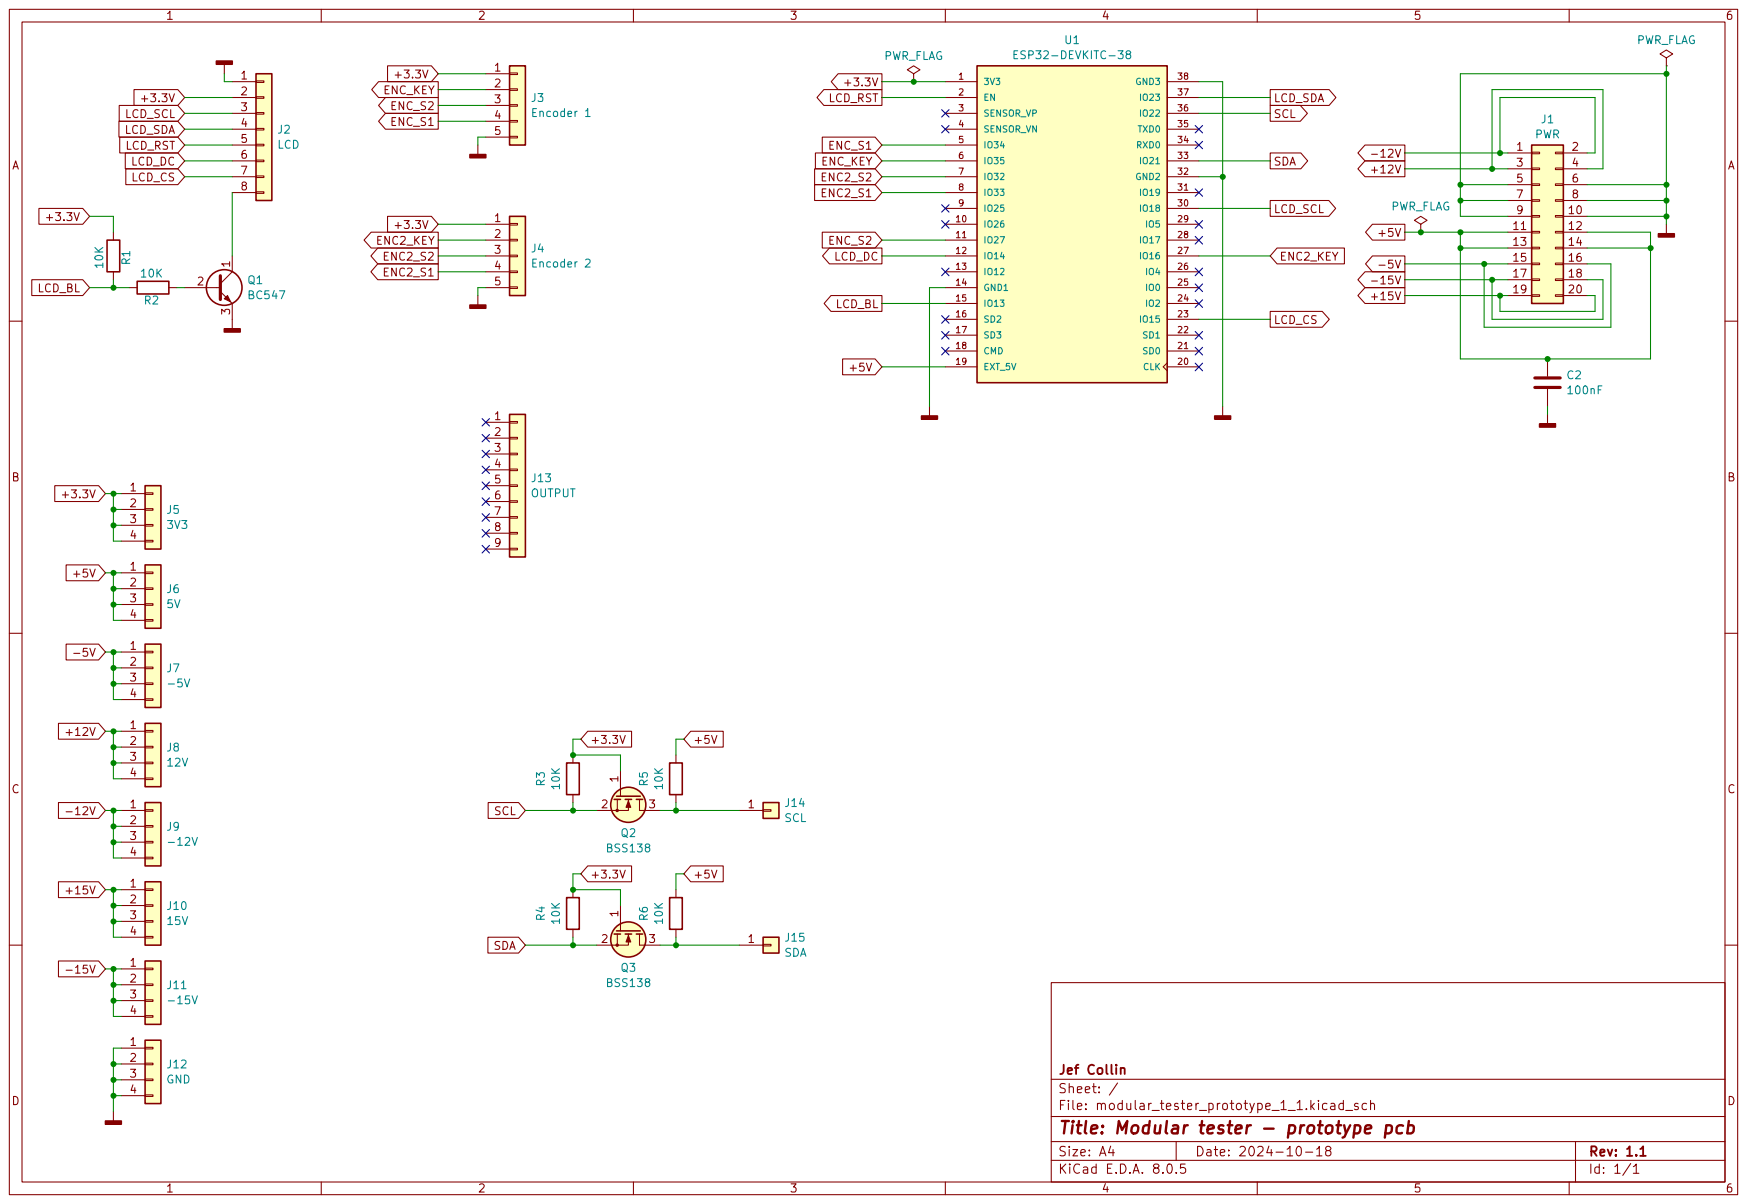
[picture p98: page 1]
