Jay-esp/modular_tester/rack_power_board/modular_tester_rack_power2.pdf

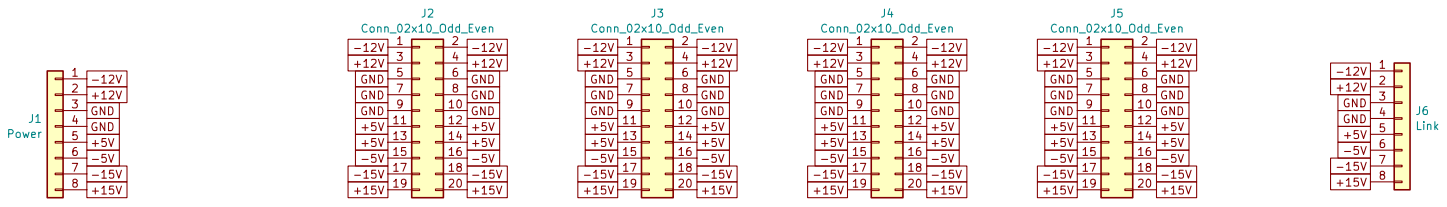
[picture p99: page 1]
