Jay-esp/modular_tester/noise_generator/src/noise_generator_1/noise_generator_1.ino

// Modular tester
// noise generator module
// Jef Collin 2024-2025


// revisions
// 1.0 first release

// use the other program to program the renesas module once



// todo




#include <TFT_eSPI.h>
#include <SPI.h>
#include "Free_Fonts.h"
#include "esp_sleep.h"
#include <Wire.h>

// use alps or other decoder
#define Use_Alps_Encoder false

TFT_eSPI LCD_DISPLAY = TFT_eSPI();  // Invoke library, pins defined in User_Setup.h

TFT_eSprite LCD_SPRITE2 = TFT_eSprite(&LCD_DISPLAY);

//  interface pins

#define noise_pwr 17
#define noise_mux_a 32
#define noise_mux_b 33

// LCD
#define Backlight_control 13

// sleep or startup
boolean noise_normalstart = false;

// mode
// 0 = off
// 1 = white noise
// 2 = pink noise
// 3 = brown noise
uint8_t noise_mode = 0;

// Menu variables
const int numMenuItems = 2;

// Menu variables
const char* menuItems[] = {"Return", "Go to sleep"};
int selectedMenu = 0;
int menuOffset = 0;

byte ScreenMode = 0;
boolean ForceNewMenu = true;

// rotary encoder
// No complete step yet.
#define DIR_NONE 0x0
// Clockwise step.
#define DIR_CW 0x10
// Anti-clockwise step.
#define DIR_CCW 0x20

#if (Use_Alps_Encoder)
// Alps EC11 encoder requires half step tables, others need full step
#define R_START 0x0
#define R_CCW_BEGIN 0x1
#define R_CW_BEGIN 0x2
#define R_START_M 0x3
#define R_CW_BEGIN_M 0x4
#define R_CCW_BEGIN_M 0x5

const unsigned char ttable[6][4] = {
  // R_START (00)
  {R_START_M,            R_CW_BEGIN,     R_CCW_BEGIN,  R_START},
  // R_CCW_BEGIN
  {R_START_M | DIR_CCW, R_START,        R_CCW_BEGIN,  R_START},
  // R_CW_BEGIN
  {R_START_M | DIR_CW,  R_CW_BEGIN,     R_START,      R_START},
  // R_START_M (11)
  {R_START_M,            R_CCW_BEGIN_M,  R_CW_BEGIN_M, R_START},
  // R_CW_BEGIN_M
  {R_START_M,            R_START_M,      R_CW_BEGIN_M, R_START | DIR_CW},
  // R_CCW_BEGIN_M
  {R_START_M,            R_CCW_BEGIN_M,  R_START_M,    R_START | DIR_CCW},
};

#else
// Use the full-step state table (emits a code at 00 only)
#define R_CW_FINAL 0x1
#define R_CW_BEGIN 0x2
#define R_CW_NEXT 0x3
#define R_CCW_BEGIN 0x4
#define R_CCW_FINAL 0x5
#define R_CCW_NEXT 0x6
#define R_START 0x0

const unsigned char ttable[7][4] = {
  // R_START
  {R_START,    R_CW_BEGIN,  R_CCW_BEGIN, R_START},
  // R_CW_FINAL
  {R_CW_NEXT,  R_START,     R_CW_FINAL,  R_START | DIR_CW},
  // R_CW_BEGIN
  {R_CW_NEXT,  R_CW_BEGIN,  R_START,     R_START},
  // R_CW_NEXT
  {R_CW_NEXT,  R_CW_BEGIN,  R_CW_FINAL,  R_START},
  // R_CCW_BEGIN
  {R_CCW_NEXT, R_START,     R_CCW_BEGIN, R_START},
  // R_CCW_FINAL
  {R_CCW_NEXT, R_CCW_FINAL, R_START,     R_START | DIR_CCW},
  // R_CCW_NEXT
  {R_CCW_NEXT, R_CCW_FINAL, R_CCW_BEGIN, R_START},
};
#endif

unsigned char Encoder_1_State = R_START;

// rotary encode io pins
char Encoder_1_Pin1 = 34;
char Encoder_1_Pin2 = 27;
char Encoder_1_Key = 36;

// track rotary encoder changes
int EncoderCounter1 = 0;

long unsigned timer_encoderbutton1;

boolean Encoder_Key1_Long_Press = false;

// interrupt routine for rotary encoder
void IRAM_ATTR isr1() {
  unsigned char pinstate = (digitalRead(Encoder_1_Pin2) << 1) | digitalRead(Encoder_1_Pin1);
  Encoder_1_State = ttable[Encoder_1_State & 0xf][pinstate];
  unsigned char result = Encoder_1_State & 0x30;
  if (result == DIR_CW) {
    if (EncoderCounter1 < 30) {
      EncoderCounter1++;
    }
  } else if (result == DIR_CCW) {
    if (EncoderCounter1 > -30) {
      EncoderCounter1--;
    }
  }
}

void setup() {

  // Serial.begin(115200);

  // we are not talking to the module but for good measures initialise the I2C bus
  Wire.begin();

  // setup encoder pins
  pinMode(Encoder_1_Pin1, INPUT);
  pinMode(Encoder_1_Pin2, INPUT);
  pinMode(Encoder_1_Key, INPUT);

  // noise off
  pinMode(noise_mux_a, OUTPUT);
  pinMode(noise_mux_b, OUTPUT);

  set_mode(noise_mode);

  // power up noise module
  pinMode(noise_pwr, OUTPUT);
  digitalWrite(noise_pwr, HIGH);

  pinMode(Backlight_control, OUTPUT);

  // turn off backlight
  digitalWrite(Backlight_control, HIGH);

  // Setup the LCD
  LCD_DISPLAY.init();
  LCD_DISPLAY.setRotation(3);
  LCD_DISPLAY.fillScreen(TFT_BLACK);
  delay(100);
  // turn on backlight
  digitalWrite(Backlight_control, LOW);

  // check for key pressed, enable normal start otherwise go to sleep
  if (digitalRead(Encoder_1_Key) == 0) {
    noise_normalstart = true;
  }

  DisplaySplash();

  if (noise_normalstart) {
    // wait until key is no longer pressed
    while (digitalRead(Encoder_1_Key) == 0) {}
  }

  if (noise_normalstart) {
    delay(4000);
  }
  else {
    delay(2500);
  }

  LCD_DISPLAY.fillScreen(TFT_BLACK);

  // goto sleep
  if (!noise_normalstart) {
    GoToSleep();
  }

  // get current state to start otherwise encoder might not react to first click
  unsigned char temppinstate1 = (digitalRead(Encoder_1_Pin2) << 1) | digitalRead(Encoder_1_Pin1);
  Encoder_1_State = ttable[Encoder_1_State & 0xf][temppinstate1];

  // setup encoder interrupts
  attachInterrupt(Encoder_1_Pin1, isr1, CHANGE);
  attachInterrupt(Encoder_1_Pin2, isr1, CHANGE);

  LCD_SPRITE2.createSprite(160, 128);

  BuildScreen(ScreenMode);

  // only for debugging
  //  report_i2c();

  update_noise();

}

void loop() {

  // change noise mode
  if (ScreenMode == 0) {
    if (EncoderCounter1 != 0) {
      if (EncoderCounter1 > 0) {
        if (noise_mode < 3) {
          noise_mode++;
          set_mode(noise_mode);
          update_noise();
        }
        EncoderCounter1--;
      }
      else {
        if (noise_mode > 0) {
          noise_mode--;
          set_mode(noise_mode);
          update_noise();
        }
        EncoderCounter1++;
      }
    }

    // key 1 long menu
    if (digitalRead(Encoder_1_Key) == 0) {
      timer_encoderbutton1 = millis();
      Encoder_Key1_Long_Press = false;
      // wait until key is no longer pressed or time expired
      while (digitalRead(Encoder_1_Key) == 0) {
        if (millis() - timer_encoderbutton1 > 1000) {
          Encoder_Key1_Long_Press = true;
          break;
        }
      }
      if (Encoder_Key1_Long_Press) {
        // long press
        ScreenMode = 10;
        selectedMenu = 0;
        menuOffset = 0;
        EncoderCounter1 = 0;
        DrawMenu();
        while (digitalRead(Encoder_1_Key) == 0) {}
        //little debounce
        delay(200);
      }
      else {
        // short press

      }
    }
  }

  switch (ScreenMode) {
    case 0:
      // running mode

      break;

    case 10:
      // menu mode
      // check for key pressed
      if (digitalRead(Encoder_1_Key) == 0) {
        switch (selectedMenu) {
          case 0:
            // return
            // rebuild all
            ScreenMode = 0;
            BuildScreen(ScreenMode);
            update_noise();
            break;

          case 1:
            // sleep
            LCD_DISPLAY.fillScreen(TFT_BLACK);
            // wait until key is no longer pressed
            while (digitalRead(Encoder_1_Key) == 0) {}
            // debounce to avoid early wakeup
            delay(100);
            GoToSleep();
            break;

        }
        // wait until key is no longer pressed
        while (digitalRead(Encoder_1_Key) == 0) {}
        // debounce
        delay(100);
      }
      // scroll menu
      if (EncoderCounter1 != 0) {
        if (EncoderCounter1 > 0) {
          if (selectedMenu < numMenuItems - 1) {
            selectedMenu++;
            if (selectedMenu >= menuOffset + 4) {
              menuOffset++;
            } else if (selectedMenu < menuOffset) {
              menuOffset--;
            }
            DrawMenu();
          }
          EncoderCounter1--;
        }
        if (EncoderCounter1 < 0) {
          if (selectedMenu > 0) {
            selectedMenu--;
            if (selectedMenu >= menuOffset + 4) {
              menuOffset++;
            } else if (selectedMenu < menuOffset) {
              menuOffset--;
            }
            DrawMenu();
          }
          EncoderCounter1++;
        }
      }
      break;
  }

}

// build screen
void BuildScreen(byte updatemode) {
  LCD_DISPLAY.fillScreen(TFT_BLACK);

}

void update_noise(void) {
  LCD_DISPLAY.setTextSize(1);
  LCD_DISPLAY.setFreeFont(FSS12);
  LCD_DISPLAY.setTextColor(TFT_GREEN, TFT_BLACK);
  LCD_DISPLAY.setTextDatum(TC_DATUM);
  LCD_DISPLAY.setTextPadding(160);
  switch (noise_mode) {
    case 0:
      // no noise
      LCD_DISPLAY.drawString("Noise off", 80, 55);
      break;

    case 1:
      LCD_DISPLAY.drawString("White Noise", 80, 55);
      break;

    case 2:
      LCD_DISPLAY.drawString("Pink Noise", 80, 55);
      break;

    case 3:
      LCD_DISPLAY.drawString("Brown Noise", 80, 55);
      break;
  }
  LCD_DISPLAY.setTextPadding(0);
}

// splash screen
void DisplaySplash(void ) {
  LCD_DISPLAY.setTextSize(1);
  LCD_DISPLAY.setFreeFont(FSS9);
  LCD_DISPLAY.fillScreen(TFT_BLACK);
  LCD_DISPLAY.setTextColor(TFT_GREEN, TFT_BLACK);
  LCD_DISPLAY.setTextDatum(TC_DATUM);
  LCD_DISPLAY.drawString("Noise Generator", 80, 0);
  LCD_DISPLAY.setTextColor(TFT_BLUE, TFT_BLACK);
  LCD_DISPLAY.setFreeFont(FSS9);
  LCD_DISPLAY.drawString("Jef Collin 2025", 80, 25);
  LCD_DISPLAY.drawString("V 1.0", 80, 45);
  // depending on startup mode, sleep or not
  if (noise_normalstart) {
    LCD_DISPLAY.setTextColor(TFT_WHITE, TFT_BLACK);
    LCD_DISPLAY.setFreeFont(GLCD);
    LCD_DISPLAY.setTextDatum(TL_DATUM);
    LCD_DISPLAY.drawString("Press R long: menu", 0, 71);
    LCD_DISPLAY.drawString("Turn R: select mode", 0, 91);
  }
  else {
    LCD_DISPLAY.setTextColor(TFT_WHITE, TFT_BLACK);
    LCD_DISPLAY.drawString("Going to sleep", 80, 85, 2);
    LCD_DISPLAY.drawString("Press knob R to wakeup", 80, 105, 2);
  }
}


// draw the menu
void DrawMenu() {
  LCD_SPRITE2.fillSprite(TFT_BLACK);
  LCD_SPRITE2.setTextDatum(TL_DATUM);
  LCD_SPRITE2.setFreeFont(FSS9);
  LCD_SPRITE2.setTextSize(1);
  LCD_SPRITE2.setTextColor(TFT_WHITE, TFT_BLACK);
  for (int i = 0; i < 4; i++) {
    int menuIndex = menuOffset + i;
    if (menuIndex >= numMenuItems) break; // Avoid drawing outside menu array
    if (menuIndex == selectedMenu) {
      LCD_SPRITE2.fillRect(0, 0 + (i * 32), 160, 32, TFT_WHITE);
      LCD_SPRITE2.setTextColor(TFT_BLACK, TFT_WHITE); // Highlight selected line
    } else {
      LCD_SPRITE2.setTextColor(TFT_WHITE, TFT_BLACK);
    }
    LCD_SPRITE2.drawString(menuItems[i], 10, 9 + (i * 32), 1);
  }
  LCD_SPRITE2.pushSprite(0, 0);
}


void GoToSleep (void) {

  // select mode 0, mux all 1
  set_mode(0);

  digitalWrite(noise_pwr, LOW);

  // shutdown the backlight
  digitalWrite(Backlight_control, HIGH);
  // lcd chip to sleep
  LCD_DISPLAY.writecommand(ST7735_SLPIN);
  // Set the wakeup source to the button pin (GPIO 36)
  esp_sleep_enable_ext0_wakeup(GPIO_NUM_36, 0); // 0 means wake up when the pin is LOW (button pressed)
  // Enter deep sleep mode
  esp_deep_sleep_start();
}

// set multiplexer
void set_mode(uint8_t mode_selector) {
  switch (mode_selector) {
    case 0:
      // no noise
      digitalWrite(noise_mux_a, HIGH);
      digitalWrite(noise_mux_b, HIGH);
      break;

    case 1:
      digitalWrite(noise_mux_a, LOW);
      digitalWrite(noise_mux_b, LOW);
      break;

    case 2:
      digitalWrite(noise_mux_a, HIGH);
      digitalWrite(noise_mux_b, LOW);
      break;

    case 3:
      digitalWrite(noise_mux_a, LOW);
      digitalWrite(noise_mux_b, HIGH);
      break;
  }
}

// only for debugging
void report_i2c(void) {

  byte error, address;
  int nDevices;

  Serial.println("Scanning...");

  nDevices = 0;
  for (address = 1; address < 127; address++ )
  {
    // The i2c_scanner uses the return value of
    // the Write.endTransmisstion to see if
    // a device did acknowledge to the address.
    Wire.beginTransmission(address);
    error = Wire.endTransmission();

    if (error == 0)
    {
      Serial.print("I2C device found at address 0x");
      if (address < 16)
        Serial.print("0");
      Serial.print(address, HEX);
      Serial.println("  !");

      nDevices++;
    }
    else if (error == 4)
    {
      Serial.print("Unknown error at address 0x");
      if (address < 16)
        Serial.print("0");
      Serial.println(address, HEX);
    }
  }
  Serial.println("Scanning end...");

  delay(1000);

}
