Jay-esp/modular_tester/fm_transmitter/src/fm_tx_4/DSEG7ClassicMini_Regular14pt7b.h

const uint8_t DSEG7ClassicMini_Regular14pt7bBitmaps[] PROGMEM = {
  0x00, 0x00, 0xFF, 0x06, 0x0C, 0x18, 0x30, 0x60, 0xC1, 0x83, 0x06, 0x0C,
  0x18, 0x30, 0x60, 0xC1, 0x83, 0xFC, 0xFF, 0x06, 0x0C, 0x18, 0x30, 0x60,
  0xC1, 0x83, 0x06, 0x0C, 0x18, 0x30, 0x60, 0xC1, 0x83, 0xFC, 0xFF, 0x06,
  0x0C, 0x18, 0x30, 0x60, 0xC1, 0x83, 0x06, 0x0C, 0x18, 0x30, 0x60, 0xC1,
  0x83, 0xFC, 0xFF, 0x06, 0x0C, 0x18, 0x30, 0x60, 0xC1, 0x83, 0x06, 0x0C,
  0x18, 0x30, 0x60, 0xC1, 0x83, 0xFC, 0xFF, 0x06, 0x0C, 0x18, 0x30, 0x60,
  0xC1, 0x83, 0x06, 0x0C, 0x18, 0x30, 0x60, 0xC1, 0x83, 0xFC, 0xFF, 0x06,
  0x0C, 0x18, 0x30, 0x60, 0xC1, 0x83, 0x06, 0x0C, 0x18, 0x30, 0x60, 0xC1,
  0x83, 0xFC, 0xFF, 0x06, 0x0C, 0x18, 0x30, 0x60, 0xC1, 0x83, 0x06, 0x0C,
  0x18, 0x30, 0x60, 0xC1, 0x83, 0xFC, 0xFF, 0x06, 0x0C, 0x18, 0x30, 0x60,
  0xC1, 0x83, 0x06, 0x0C, 0x18, 0x30, 0x60, 0xC1, 0x83, 0xFC, 0xFF, 0x06,
  0x0C, 0x18, 0x30, 0x60, 0xC1, 0x83, 0x06, 0x0C, 0x18, 0x30, 0x60, 0xC1,
  0x83, 0xFC, 0xFF, 0x06, 0x0C, 0x18, 0x30, 0x60, 0xC1, 0x83, 0x06, 0x0C,
  0x18, 0x30, 0x60, 0xC1, 0x83, 0xFC, 0xFF, 0x06, 0x0C, 0x18, 0x30, 0x60,
  0xC1, 0x83, 0x06, 0x0C, 0x18, 0x30, 0x60, 0xC1, 0x83, 0xFC, 0x7F, 0xEF,
  0xFF, 0x7F, 0xE0, 0x6F, 0x60, 0xFF, 0x06, 0x0C, 0x18, 0x30, 0x60, 0xC1,
  0x83, 0x06, 0x0C, 0x18, 0x30, 0x60, 0xC1, 0x83, 0xFC, 0x3F, 0xFC, 0x3F,
  0xFC, 0x9F, 0xF9, 0xC0, 0x03, 0xC0, 0x03, 0xC0, 0x03, 0xC0, 0x03, 0xC0,
  0x03, 0xC0, 0x03, 0xC0, 0x03, 0xC0, 0x03, 0x80, 0x01, 0x00, 0x00, 0x00,
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
  {  1046,  16,  27,  22,    3,  -26 },   // 0x47 'G'
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

const GFXfont DSEG7ClassicMini_Regular14pt7b PROGMEM = {
  (uint8_t  *)DSEG7ClassicMini_Regular14pt7bBitmaps,
  (GFXglyph *)DSEG7ClassicMini_Regular14pt7bGlyphs,
  0x20, 0x7E, 30 };

// Approx. 3828 bytes
