Jay-esp/modular_tester/fm_transmitter/src/fm_tx_4/DSEG7ClassicMini_Regular17pt7b.h

const uint8_t DSEG7ClassicMini_Regular17pt7bBitmaps[] PROGMEM = {
  0x00, 0x00, 0xFF, 0xC0, 0x60, 0x30, 0x18, 0x0C, 0x06, 0x03, 0x01, 0x80,
  0xC0, 0x60, 0x30, 0x18, 0x0C, 0x06, 0x03, 0x01, 0x80, 0xC0, 0x60, 0x30,
  0x18, 0x0F, 0xFC, 0xFF, 0xC0, 0x60, 0x30, 0x18, 0x0C, 0x06, 0x03, 0x01,
  0x80, 0xC0, 0x60, 0x30, 0x18, 0x0C, 0x06, 0x03, 0x01, 0x80, 0xC0, 0x60,
  0x30, 0x18, 0x0F, 0xFC, 0xFF, 0xC0, 0x60, 0x30, 0x18, 0x0C, 0x06, 0x03,
  0x01, 0x80, 0xC0, 0x60, 0x30, 0x18, 0x0C, 0x06, 0x03, 0x01, 0x80, 0xC0,
  0x60, 0x30, 0x18, 0x0F, 0xFC, 0xFF, 0xC0, 0x60, 0x30, 0x18, 0x0C, 0x06,
  0x03, 0x01, 0x80, 0xC0, 0x60, 0x30, 0x18, 0x0C, 0x06, 0x03, 0x01, 0x80,
  0xC0, 0x60, 0x30, 0x18, 0x0F, 0xFC, 0xFF, 0xC0, 0x60, 0x30, 0x18, 0x0C,
  0x06, 0x03, 0x01, 0x80, 0xC0, 0x60, 0x30, 0x18, 0x0C, 0x06, 0x03, 0x01,
  0x80, 0xC0, 0x60, 0x30, 0x18, 0x0F, 0xFC, 0xFF, 0xC0, 0x60, 0x30, 0x18,
  0x0C, 0x06, 0x03, 0x01, 0x80, 0xC0, 0x60, 0x30, 0x18, 0x0C, 0x06, 0x03,
  0x01, 0x80, 0xC0, 0x60, 0x30, 0x18, 0x0F, 0xFC, 0xFF, 0xC0, 0x60, 0x30,
  0x18, 0x0C, 0x06, 0x03, 0x01, 0x80, 0xC0, 0x60, 0x30, 0x18, 0x0C, 0x06,
  0x03, 0x01, 0x80, 0xC0, 0x60, 0x30, 0x18, 0x0F, 0xFC, 0xFF, 0xC0, 0x60,
  0x30, 0x18, 0x0C, 0x06, 0x03, 0x01, 0x80, 0xC0, 0x60, 0x30, 0x18, 0x0C,
  0x06, 0x03, 0x01, 0x80, 0xC0, 0x60, 0x30, 0x18, 0x0F, 0xFC, 0xFF, 0xC0,
  0x60, 0x30, 0x18, 0x0C, 0x06, 0x03, 0x01, 0x80, 0xC0, 0x60, 0x30, 0x18,
  0x0C, 0x06, 0x03, 0x01, 0x80, 0xC0, 0x60, 0x30, 0x18, 0x0F, 0xFC, 0xFF,
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
  {  1668,  21,  33,  27,    3,  -32 },   // 0x47 'G'
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

const GFXfont DSEG7ClassicMini_Regular17pt7b PROGMEM = {
  (uint8_t  *)DSEG7ClassicMini_Regular17pt7bBitmaps,
  (GFXglyph *)DSEG7ClassicMini_Regular17pt7bGlyphs,
  0x20, 0x7E, 36 };

// Approx. 5757 bytes
