Jay-esp/modular_tester/fm_transmitter/src/fm_tx_4/DSEG7ClassicMini_Regular20pt7b.h

const uint8_t DSEG7ClassicMini_Regular20pt7bBitmaps[] PROGMEM = {
  0x00, 0x00, 0xFF, 0xE0, 0x18, 0x06, 0x01, 0x80, 0x60, 0x18, 0x06, 0x01,
  0x80, 0x60, 0x18, 0x06, 0x01, 0x80, 0x60, 0x18, 0x06, 0x01, 0x80, 0x60,
  0x18, 0x06, 0x01, 0x80, 0x60, 0x18, 0x06, 0x01, 0x80, 0x7F, 0xF0, 0xFF,
  0xE0, 0x18, 0x06, 0x01, 0x80, 0x60, 0x18, 0x06, 0x01, 0x80, 0x60, 0x18,
  0x06, 0x01, 0x80, 0x60, 0x18, 0x06, 0x01, 0x80, 0x60, 0x18, 0x06, 0x01,
  0x80, 0x60, 0x18, 0x06, 0x01, 0x80, 0x7F, 0xF0, 0xFF, 0xE0, 0x18, 0x06,
  0x01, 0x80, 0x60, 0x18, 0x06, 0x01, 0x80, 0x60, 0x18, 0x06, 0x01, 0x80,
  0x60, 0x18, 0x06, 0x01, 0x80, 0x60, 0x18, 0x06, 0x01, 0x80, 0x60, 0x18,
  0x06, 0x01, 0x80, 0x7F, 0xF0, 0xFF, 0xE0, 0x18, 0x06, 0x01, 0x80, 0x60,
  0x18, 0x06, 0x01, 0x80, 0x60, 0x18, 0x06, 0x01, 0x80, 0x60, 0x18, 0x06,
  0x01, 0x80, 0x60, 0x18, 0x06, 0x01, 0x80, 0x60, 0x18, 0x06, 0x01, 0x80,
  0x7F, 0xF0, 0xFF, 0xE0, 0x18, 0x06, 0x01, 0x80, 0x60, 0x18, 0x06, 0x01,
  0x80, 0x60, 0x18, 0x06, 0x01, 0x80, 0x60, 0x18, 0x06, 0x01, 0x80, 0x60,
  0x18, 0x06, 0x01, 0x80, 0x60, 0x18, 0x06, 0x01, 0x80, 0x7F, 0xF0, 0xFF,
  0xE0, 0x18, 0x06, 0x01, 0x80, 0x60, 0x18, 0x06, 0x01, 0x80, 0x60, 0x18,
  0x06, 0x01, 0x80, 0x60, 0x18, 0x06, 0x01, 0x80, 0x60, 0x18, 0x06, 0x01,
  0x80, 0x60, 0x18, 0x06, 0x01, 0x80, 0x7F, 0xF0, 0xFF, 0xE0, 0x18, 0x06,
  0x01, 0x80, 0x60, 0x18, 0x06, 0x01, 0x80, 0x60, 0x18, 0x06, 0x01, 0x80,
  0x60, 0x18, 0x06, 0x01, 0x80, 0x60, 0x18, 0x06, 0x01, 0x80, 0x60, 0x18,
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
  {  2226,  24,  39,  32,    4,  -38 },   // 0x47 'G'
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

const GFXfont DSEG7ClassicMini_Regular20pt7b PROGMEM = {
  (uint8_t  *)DSEG7ClassicMini_Regular20pt7bBitmaps,
  (GFXglyph *)DSEG7ClassicMini_Regular20pt7bGlyphs,
  0x20, 0x7E, 43 };

// Approx. 7424 bytes
