Jay-esp/modular_tester/fm_transmitter/src/fm_tx_4/DSEG7ClassicMini_Regular22pt7b.h

const uint8_t DSEG7ClassicMini_Regular22pt7bBitmaps[] PROGMEM = {
  0x00, 0x00, 0xFF, 0xF0, 0x06, 0x00, 0xC0, 0x18, 0x03, 0x00, 0x60, 0x0C,
  0x01, 0x80, 0x30, 0x06, 0x00, 0xC0, 0x18, 0x03, 0x00, 0x60, 0x0C, 0x01,
  0x80, 0x30, 0x06, 0x00, 0xC0, 0x18, 0x03, 0x00, 0x60, 0x0C, 0x01, 0x80,
  0x30, 0x06, 0x00, 0xFF, 0xF0, 0xFF, 0xF0, 0x06, 0x00, 0xC0, 0x18, 0x03,
  0x00, 0x60, 0x0C, 0x01, 0x80, 0x30, 0x06, 0x00, 0xC0, 0x18, 0x03, 0x00,
  0x60, 0x0C, 0x01, 0x80, 0x30, 0x06, 0x00, 0xC0, 0x18, 0x03, 0x00, 0x60,
  0x0C, 0x01, 0x80, 0x30, 0x06, 0x00, 0xFF, 0xF0, 0xFF, 0xF0, 0x06, 0x00,
  0xC0, 0x18, 0x03, 0x00, 0x60, 0x0C, 0x01, 0x80, 0x30, 0x06, 0x00, 0xC0,
  0x18, 0x03, 0x00, 0x60, 0x0C, 0x01, 0x80, 0x30, 0x06, 0x00, 0xC0, 0x18,
  0x03, 0x00, 0x60, 0x0C, 0x01, 0x80, 0x30, 0x06, 0x00, 0xFF, 0xF0, 0xFF,
  0xF0, 0x06, 0x00, 0xC0, 0x18, 0x03, 0x00, 0x60, 0x0C, 0x01, 0x80, 0x30,
  0x06, 0x00, 0xC0, 0x18, 0x03, 0x00, 0x60, 0x0C, 0x01, 0x80, 0x30, 0x06,
  0x00, 0xC0, 0x18, 0x03, 0x00, 0x60, 0x0C, 0x01, 0x80, 0x30, 0x06, 0x00,
  0xFF, 0xF0, 0xFF, 0xF0, 0x06, 0x00, 0xC0, 0x18, 0x03, 0x00, 0x60, 0x0C,
  0x01, 0x80, 0x30, 0x06, 0x00, 0xC0, 0x18, 0x03, 0x00, 0x60, 0x0C, 0x01,
  0x80, 0x30, 0x06, 0x00, 0xC0, 0x18, 0x03, 0x00, 0x60, 0x0C, 0x01, 0x80,
  0x30, 0x06, 0x00, 0xFF, 0xF0, 0xFF, 0xF0, 0x06, 0x00, 0xC0, 0x18, 0x03,
  0x00, 0x60, 0x0C, 0x01, 0x80, 0x30, 0x06, 0x00, 0xC0, 0x18, 0x03, 0x00,
  0x60, 0x0C, 0x01, 0x80, 0x30, 0x06, 0x00, 0xC0, 0x18, 0x03, 0x00, 0x60,
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
  {  2738,  27,  43,  35,    4,  -42 },   // 0x47 'G'
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

const GFXfont DSEG7ClassicMini_Regular22pt7b PROGMEM = {
  (uint8_t  *)DSEG7ClassicMini_Regular22pt7bBitmaps,
  (GFXglyph *)DSEG7ClassicMini_Regular22pt7bGlyphs,
  0x20, 0x7E, 47 };

// Approx. 9055 bytes
