Jay-esp/modular_tester/noise_generator/src/noise_generator_program_1/slg47004_config.h

#ifndef SLG47004_CONFIG_H
#define SLG47004_CONFIG_H

const uint8_t slg47004_config[] = {
    0xD7, 0xB0, 0x6F, 0xBB, 0x40, 0x00, 0xFB, 0xC0, 0xEF, 0x05, 0xBF, 0x1B, 0xFC, 0x7E, 0xF0, 0x3B,
    0xC2, 0xEF, 0x09, 0xBF, 0x2B, 0xFC, 0xCE, 0x77, 0x3B, 0xFF, 0xEC, 0x7C, 0xB4, 0xF3, 0xD3, 0xCE,
    0x57, 0x3B, 0x7F, 0x05, 0xDE, 0xBE, 0x2F, 0x3C, 0xD0, 0xD8, 0x1F, 0xC1, 0x7F, 0x00, 0x00, 0x00,
    0xCD, 0x0F, 0x00, 0x00, 0x90, 0xFD, 0x00, 0x00, 0x00, 0x00, 0x00, 0x00, 0x00, 0x00, 0x00, 0x00,
    0x00, 0x00, 0x00, 0x00, 0x00, 0x00, 0x00, 0x00, 0x3C, 0x0F, 0xF0, 0x00, 0x02, 0x00, 0x80, 0x00,
    0x00, 0x00, 0x08, 0x04, 0x00, 0x00, 0x1D, 0x50, 0x09, 0x80, 0x00, 0x00, 0x00, 0x0F, 0x00, 0xDF,
    0xDF, 0xF3, 0x00, 0x00, 0x00, 0x00, 0x00, 0x3F, 0x00, 0x00, 0xF0, 0x02, 0x2F, 0x00, 0x00, 0xC0,
    0x3F, 0x3F, 0x08, 0x00, 0x40, 0x40, 0x04, 0x0C, 0x0C, 0x00, 0x00, 0x00, 0x00, 0x01, 0x00, 0x01,
    0xA5, 0x00, 0x00, 0x00, 0x00, 0x00, 0x00, 0x00, 0x00, 0x00, 0x00, 0x30, 0x00, 0x00, 0x00, 0x00,
    0x00, 0x83, 0x11, 0x60, 0x30, 0x02, 0x6C, 0x00, 0x00, 0x10, 0x00, 0x10, 0x20, 0x10, 0x20, 0x10,
    0x20, 0x10, 0x20, 0x10, 0x20, 0x10, 0x20, 0x00, 0x00, 0x69, 0x96, 0x01, 0x00, 0x00, 0x01, 0x00,
    0x01, 0x00, 0x01, 0x00, 0x01, 0x00, 0x01, 0x00, 0x01, 0x09, 0x60, 0x00, 0x00, 0xC5, 0x00, 0x00,
    0xFF, 0x03, 0x00, 0x00, 0x00, 0x00, 0x00, 0x00, 0x00, 0x00, 0x00, 0x00, 0x00, 0x00, 0x00, 0x00,
    0xFF, 0x03, 0x00, 0x00, 0x00, 0x00, 0x00, 0x00, 0x00, 0x00, 0x00, 0x00, 0x00, 0x00, 0x00, 0x00,
    0x00, 0x00, 0x00, 0x00, 0x00, 0x00, 0x00, 0x00, 0x00, 0x00, 0x00, 0x00, 0x00, 0x00, 0x00, 0x00,
    0x5A, 0x00, 0x00, 0x01, 0x00, 0x00, 0x00, 0x00, 0x00, 0x00, 0x00, 0x00, 0x00, 0x00, 0x00, 0x00,
};

#endif // SLG47004_CONFIG_H
