Jay-esp/modular_tester/cb_microphone_tester/src/cb_tester_11/DIN_1451_Mittelschrift_Regular8pt7b.h

const uint8_t DIN_1451_Mittelschrift_Regular8pt7bBitmaps[] PROGMEM = {
  0x00, 0xFF, 0xFF, 0x0C, 0xB6, 0x80, 0x24, 0x48, 0x97, 0xF6, 0xCD, 0x9B,
  0x7F, 0x48, 0x91, 0x20, 0x10, 0xFB, 0xF6, 0x8D, 0x1E, 0x1F, 0x0F, 0x16,
  0x2F, 0xFB, 0xC1, 0x02, 0x00, 0xE3, 0x4A, 0xB7, 0x41, 0x82, 0x0C, 0x17,
  0x6A, 0x96, 0x38, 0x3C, 0x19, 0x86, 0x61, 0xF8, 0x38, 0x1E, 0x0C, 0xCF,
  0x1A, 0xC3, 0x99, 0xE3, 0xEC, 0x3C, 0x22, 0x6C, 0xCC, 0xCC, 0xC4, 0x22,
  0x44, 0x63, 0x33, 0x33, 0x36, 0x44, 0x23, 0x9C, 0x40, 0x10, 0x10, 0x10,
  0x10, 0xFF, 0x10, 0x10, 0x10, 0xF0, 0xF8, 0xC0, 0x08, 0xC4, 0x23, 0x10,
  0x8C, 0x42, 0x30, 0x39, 0x8F, 0x1E, 0x3C, 0x78, 0xF1, 0xE3, 0xC7, 0x8D,
  0xE0, 0x7F, 0xB3, 0x33, 0x33, 0x33, 0x30, 0x79, 0x9B, 0x18, 0x30, 0xE3,
  0x86, 0x18, 0x71, 0xC3, 0xF8, 0x39, 0x9B, 0x18, 0x30, 0xE7, 0x83, 0x83,
  0x07, 0x9D, 0xE0, 0x18, 0x20, 0xC1, 0x86, 0x0D, 0x93, 0x66, 0xFE, 0x18,
  0x30, 0xFF, 0x0C, 0x3E, 0xCC, 0x30, 0xC3, 0xCF, 0x37, 0x80, 0x18, 0x30,
  0xC1, 0x86, 0x0F, 0xB1, 0xE3, 0xC7, 0x8C, 0xF0, 0xFF, 0x8B, 0x30, 0x61,
  0x83, 0x06, 0x18, 0x30, 0x41, 0x80, 0x38, 0xDB, 0x1E, 0x3C, 0x6F, 0xBB,
  0xE3, 0xC7, 0xDC, 0xE0, 0x39, 0x8B, 0x1E, 0x3C, 0x6F, 0x83, 0x0C, 0x18,
  0x60, 0xC0, 0xC0, 0xC0, 0xC3, 0xC0, 0x03, 0x0E, 0x38, 0xC0, 0xE0, 0x38,
  0x07, 0x01, 0xFF, 0x00, 0x00, 0xFF, 0xC0, 0x70, 0x1C, 0x03, 0x07, 0x1C,
  0xE0, 0x80, 0x7B, 0x3C, 0xC3, 0x1C, 0x63, 0x0C, 0x30, 0x03, 0x00, 0x1F,
  0x04, 0x19, 0x3B, 0x48, 0xDB, 0x13, 0x42, 0x68, 0xDD, 0x12, 0x5F, 0x84,
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
  {   298,   8,  11,  10,    1,  -10 },   // 0x47 'G'
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

const GFXfont DIN_1451_Mittelschrift_Regular8pt7b PROGMEM = {
  (uint8_t  *)DIN_1451_Mittelschrift_Regular8pt7bBitmaps,
  (GFXglyph *)DIN_1451_Mittelschrift_Regular8pt7bGlyphs,
  0x20, 0x7E, 18 };

// Approx. 1452 bytes
